SverreOK/hoppen_fc/hoppen_fc/hoppen_fc.kicad_pcb

## KiCad design hoppen_fc/hoppen_fc.kicad_pcb (2026-03-31)

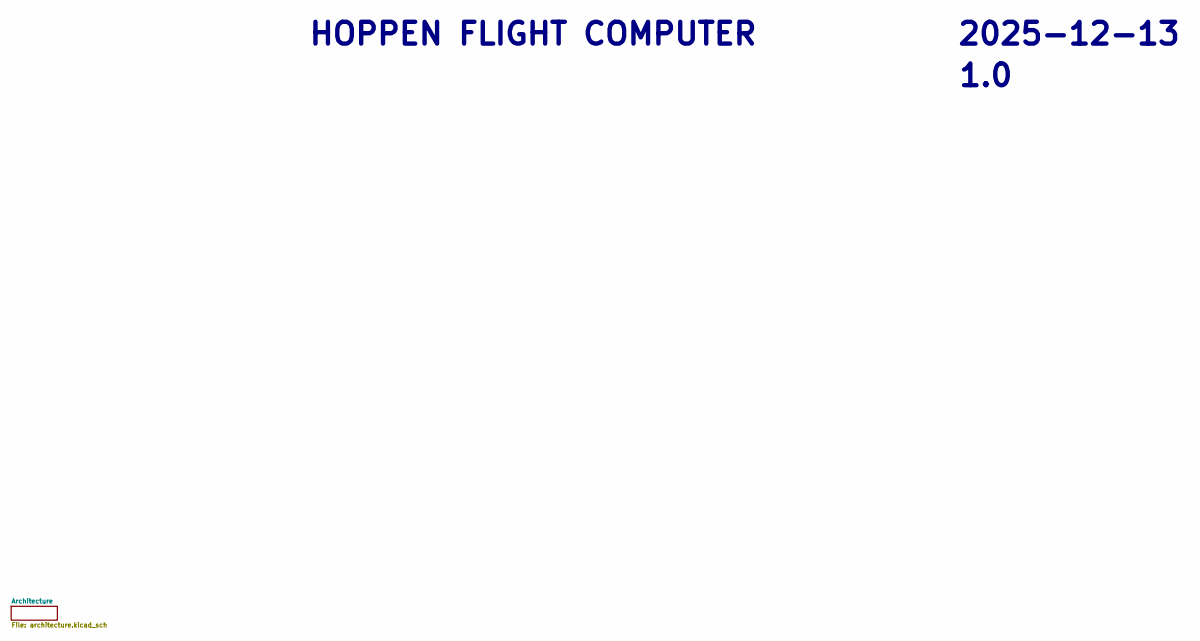
[picture p1: schematic hoppen_fc.kicad_sch, MCU Power]

Notes on the sheet:
${REVISION}
HOPPEN FLIGHT COMPUTER
${ISSUE_DATE}

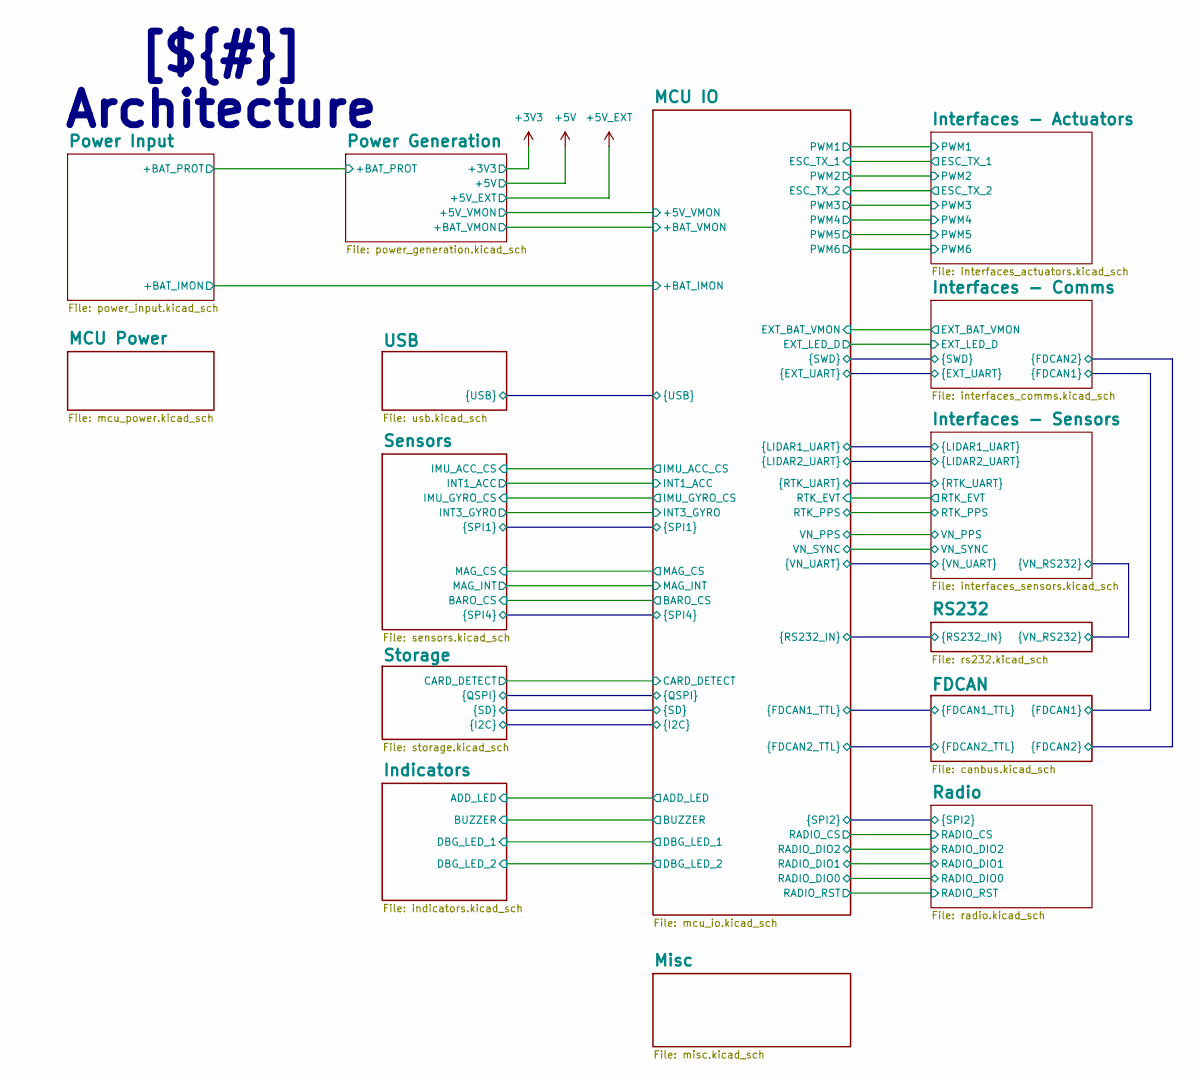
[picture p2: schematic architecture.kicad_sch]

Notes on the sheet:
[${#}] ${TITLE}

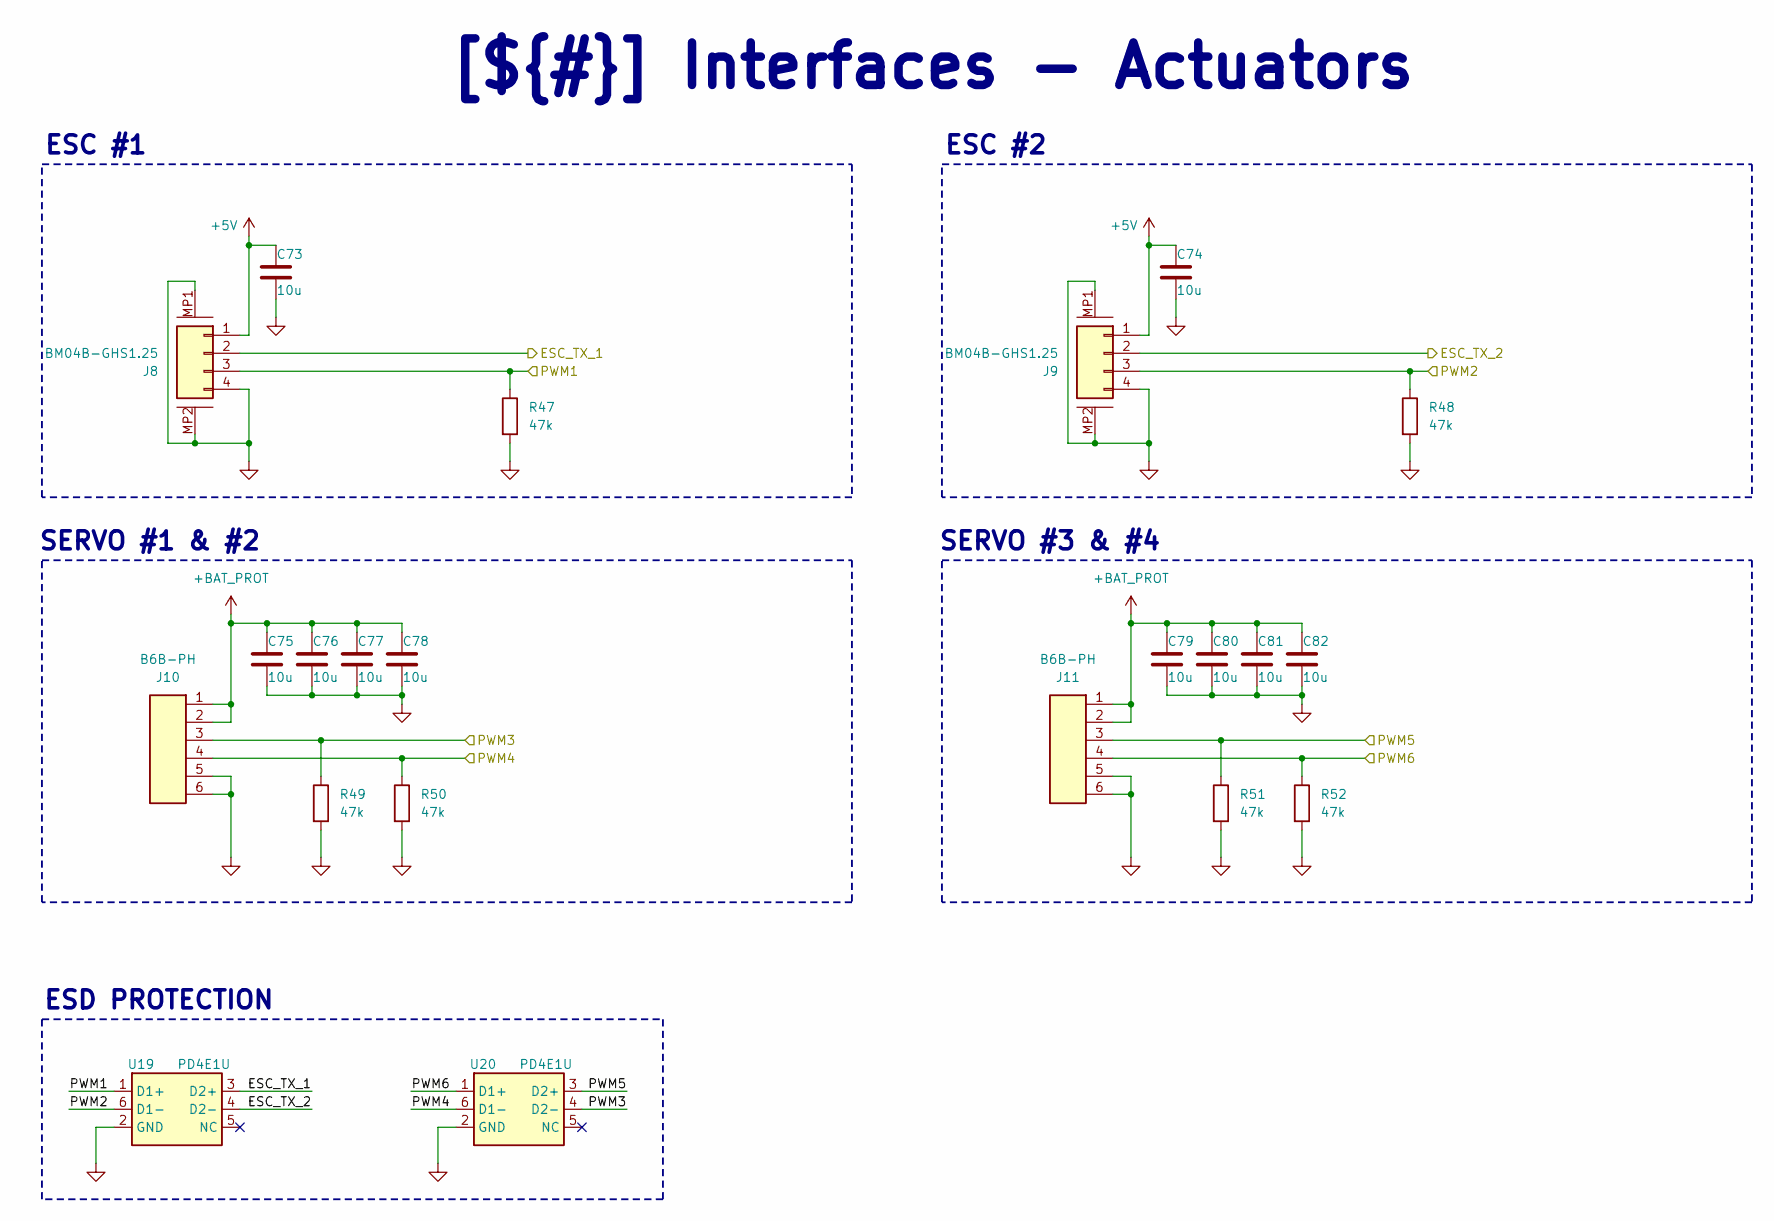
[picture p3: schematic interfaces_actuators.kicad_sch, Interfaces - Actuators]

Parts:
C73, C74, C75, C76, C77, C78, C79, C80, C81, C82: 10u; C_0805_2012Metric; LCSC C440198
J8, J9: BM04B-GHS1.25; LCSC C161692
J10, J11: B6B-PH; JST_PH_B6B-PH-K_1x06_P2.00mm_Vertical
R47, R48, R49, R50, R51, R52: 47k; R_0402_1005Metric; LCSC C25792
U19, U20: PD4E1U; SOT-363_SC-70-6; LCSC C194628

Connections:
+5V: C73.1, C74.1, J8.1, J9.1; also elsewhere on the board
+BAT_PROT: C75.1, C76.1, C77.1, C78.1, C79.1, C80.1, C81.1, C82.1, J10.1, J10.2, J11.1, J11.2; also elsewhere on the board
/Architecture/Interfaces - Actuators/ESC_TX_1: J8.2, U19.3 (D2+); also elsewhere on the board
/Architecture/Interfaces - Actuators/ESC_TX_2: J9.2, U19.4 (D2-); also elsewhere on the board
/Architecture/Interfaces - Actuators/PWM1: J8.3, R47.1, U19.1 (D1+); also elsewhere on the board
/Architecture/Interfaces - Actuators/PWM2: J9.3, R48.1, U19.6 (D1-); also elsewhere on the board
/Architecture/Interfaces - Actuators/PWM3: J10.3, R49.1, U20.4 (D2-); also elsewhere on the board
/Architecture/Interfaces - Actuators/PWM4: J10.4, R50.1, U20.6 (D1-); also elsewhere on the board
/Architecture/Interfaces - Actuators/PWM5: J11.3, R51.1, U20.3 (D2+); also elsewhere on the board
/Architecture/Interfaces - Actuators/PWM6: J11.4, R52.1, U20.1 (D1+); also elsewhere on the board
GND: C73.2, C74.2, C75.2, C76.2, C77.2, C78.2, C79.2, C80.2, C81.2, C82.2, J8.4, J8.MP1, J8.MP2, J9.4, J9.MP1, J9.MP2, J10.5, J10.6, J11.5, J11.6, R47.2, R48.2, R49.2, R50.2, R51.2, R52.2, U19.2 (GND), U20.2 (GND); also elsewhere on the board

Notes on the sheet:
SERVO #1 & #2
ESD PROTECTION
SERVO #3 & #4
ESC #2
ESC #1
[${#}] ${TITLE}

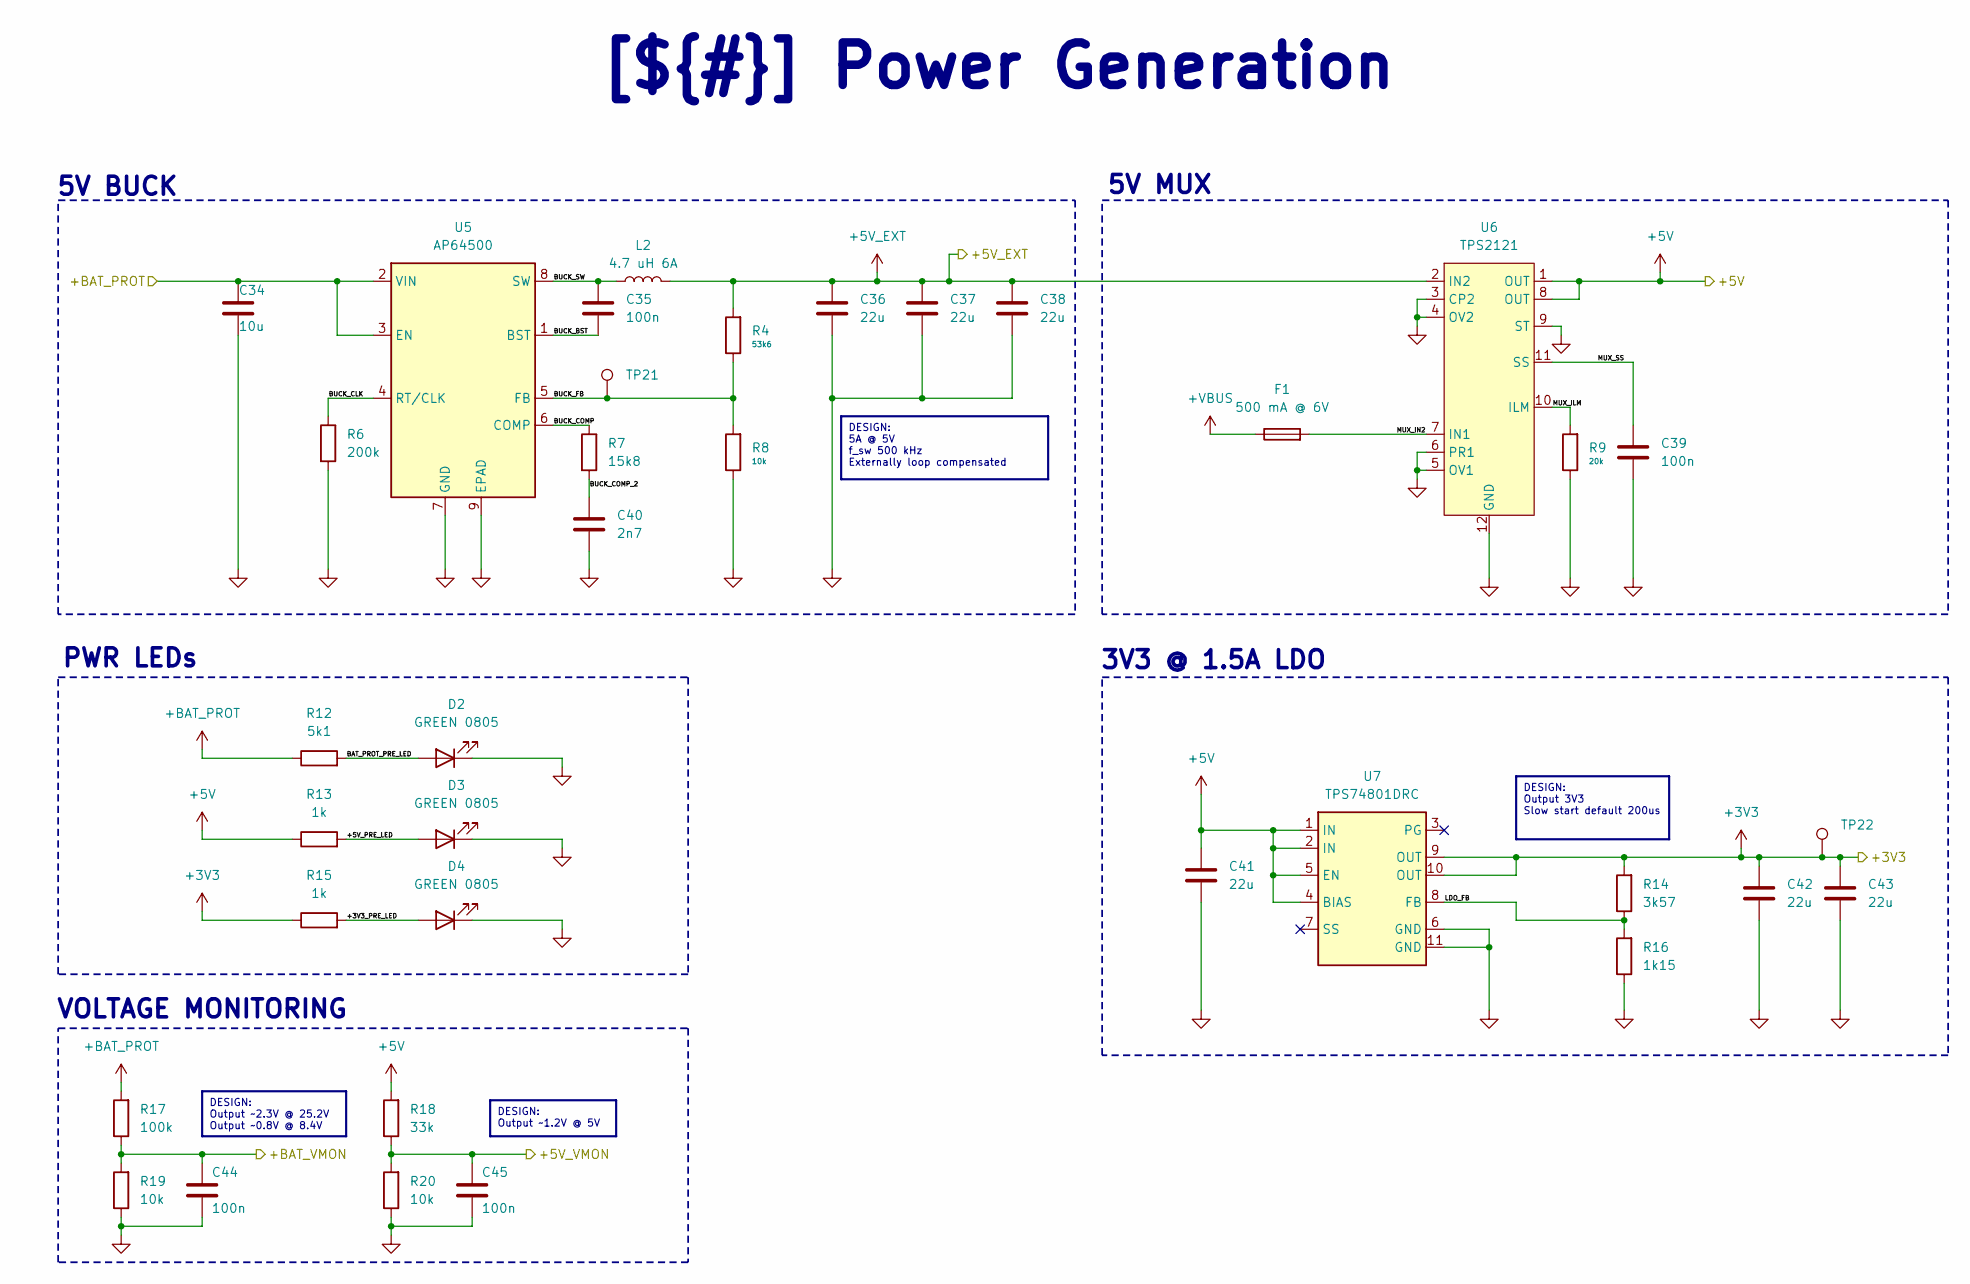
[picture p4: schematic power_generation.kicad_sch, Power Generation]

Parts:
C34: 10u; C_0805_2012Metric; LCSC C440198
C35, C39, C44, C45: 100n; C_0402_1005Metric; LCSC C307331
C36, C37, C38, C41, C42, C43: 22u; C_0805_2012Metric; LCSC C45783
C40: 2n7; C_0402_1005Metric; LCSC C106251
D2, D3, D4: GREEN 0805; LED_0805_2012Metric; LCSC C2297
F1: 500 mA @ 6V; Fuse_0603_1608Metric; LCSC C210357
L2: 4.7 uH 6A; IND-SMD_L7.2-W6.6_GPSR07X0; LCSC C5189754
R4: 53k6; R_0402_1005Metric; LCSC C53398
R6: 200k; R_0402_1005Metric; LCSC C25764
R7: 15k8; R_0402_1005Metric; LCSC C26956
R8, R19, R20: 10k; R_0402_1005Metric; LCSC C25744
R9: 20k; R_0402_1005Metric; LCSC C25765
R12: 5k1; R_0402_1005Metric; LCSC C25905
R13, R15: 1k; R_0402_1005Metric; LCSC C106235
R14: 3k57; R_0402_1005Metric; LCSC C270609
R16: 1k15; R_0402_1005Metric; LCSC C5159680
R17: 100k; R_0402_1005Metric; LCSC C25741
R18: 33k; R_0402_1005Metric; LCSC C25779
TP21, TP22: TestPoint; TestPoint_Pad_1.0x1.0mm
U5: AP64500; SO-8-EP; LCSC C2070920
U6: TPS2121; Texas_VQFN-HR-12_2x2.5mm_P0.5mm; LCSC C2156025
U7: TPS74801DRC; VSON-10; LCSC C105263

Connections:
+3V3: C42.1, C43.1, R14.2, R15.1, TP22.1, U7.9 (OUT), U7.10 (OUT); also elsewhere on the board
+5V: C41.1, R13.1, R18.2, U6.1 (OUT), U6.8 (OUT), U7.1 (IN), U7.2 (IN), U7.4 (BIAS), U7.5 (EN); also elsewhere on the board
+5V_EXT: C36.1, C37.1, C38.1, L2.2, R4.2, U6.2 (IN2); also elsewhere on the board
+BAT_PROT: C34.1, R12.1, R17.2, U5.2 (VIN), U5.3 (EN); also elsewhere on the board
+VBUS: F1.1; also elsewhere on the board
/Architecture/MCU IO/+5V_VMON: C45.2, R18.1, R20.2; also elsewhere on the board
/Architecture/MCU IO/+BAT_VMON: C44.2, R17.1, R19.2; also elsewhere on the board
/Architecture/Power Generation/+3V3_PRE_LED: D4.2 (A), R15.2
/Architecture/Power Generation/+5V_PRE_LED: D3.2 (A), R13.2
/Architecture/Power Generation/BAT_PROT_PRE_LED: D2.2 (A), R12.2
/Architecture/Power Generation/BUCK_BST: C35.2, U5.1 (BST)
/Architecture/Power Generation/BUCK_CLK: R6.1, U5.4 (RT/CLK)
/Architecture/Power Generation/BUCK_COMP: R7.1, U5.6 (COMP)
/Architecture/Power Generation/BUCK_COMP_2: C40.1, R7.2
/Architecture/Power Generation/BUCK_FB: R4.1, R8.2, TP21.1, U5.5 (FB)
/Architecture/Power Generation/BUCK_SW: C35.1, L2.1, U5.8 (SW)
/Architecture/Power Generation/LDO_FB: R14.1, R16.2, U7.8 (FB)
/Architecture/Power Generation/MUX_ILM: R9.2, U6.10 (ILM)
/Architecture/Power Generation/MUX_IN2: F1.2, U6.7 (IN1)
/Architecture/Power Generation/MUX_SS: C39.1, U6.11 (SS)
GND: C34.2, C36.2, C37.2, C38.2, C39.2, C40.2, C41.2, C42.2, C43.2, C44.1, C45.1, D2.1 (K), D3.1 (K), D4.1 (K), R6.2, R8.1, R9.1, R16.1, R19.1, R20.1, U5.7 (GND), U5.9 (EPAD), U6.3 (CP2), U6.4 (OV2), U6.5 (OV1), U6.6 (PR1), U6.9 (ST), U6.12 (GND), U7.6 (GND), U7.11 (GND); also elsewhere on the board

Notes on the sheet:
5V MUX
PWR LEDs
5V BUCK
VOLTAGE MONITORING
3V3 @ 1.5A LDO
[${#}] ${TITLE}
DESIGN: Output 3V3 Slow start default 200us
DESIGN: 5A @ 5V f_sw 500 kHz Externally loop compensated
DESIGN: Output ~1.2V @ 5V
DESIGN: Output ~2.3V @ 25.2V Output ~0.8V @ 8.4V

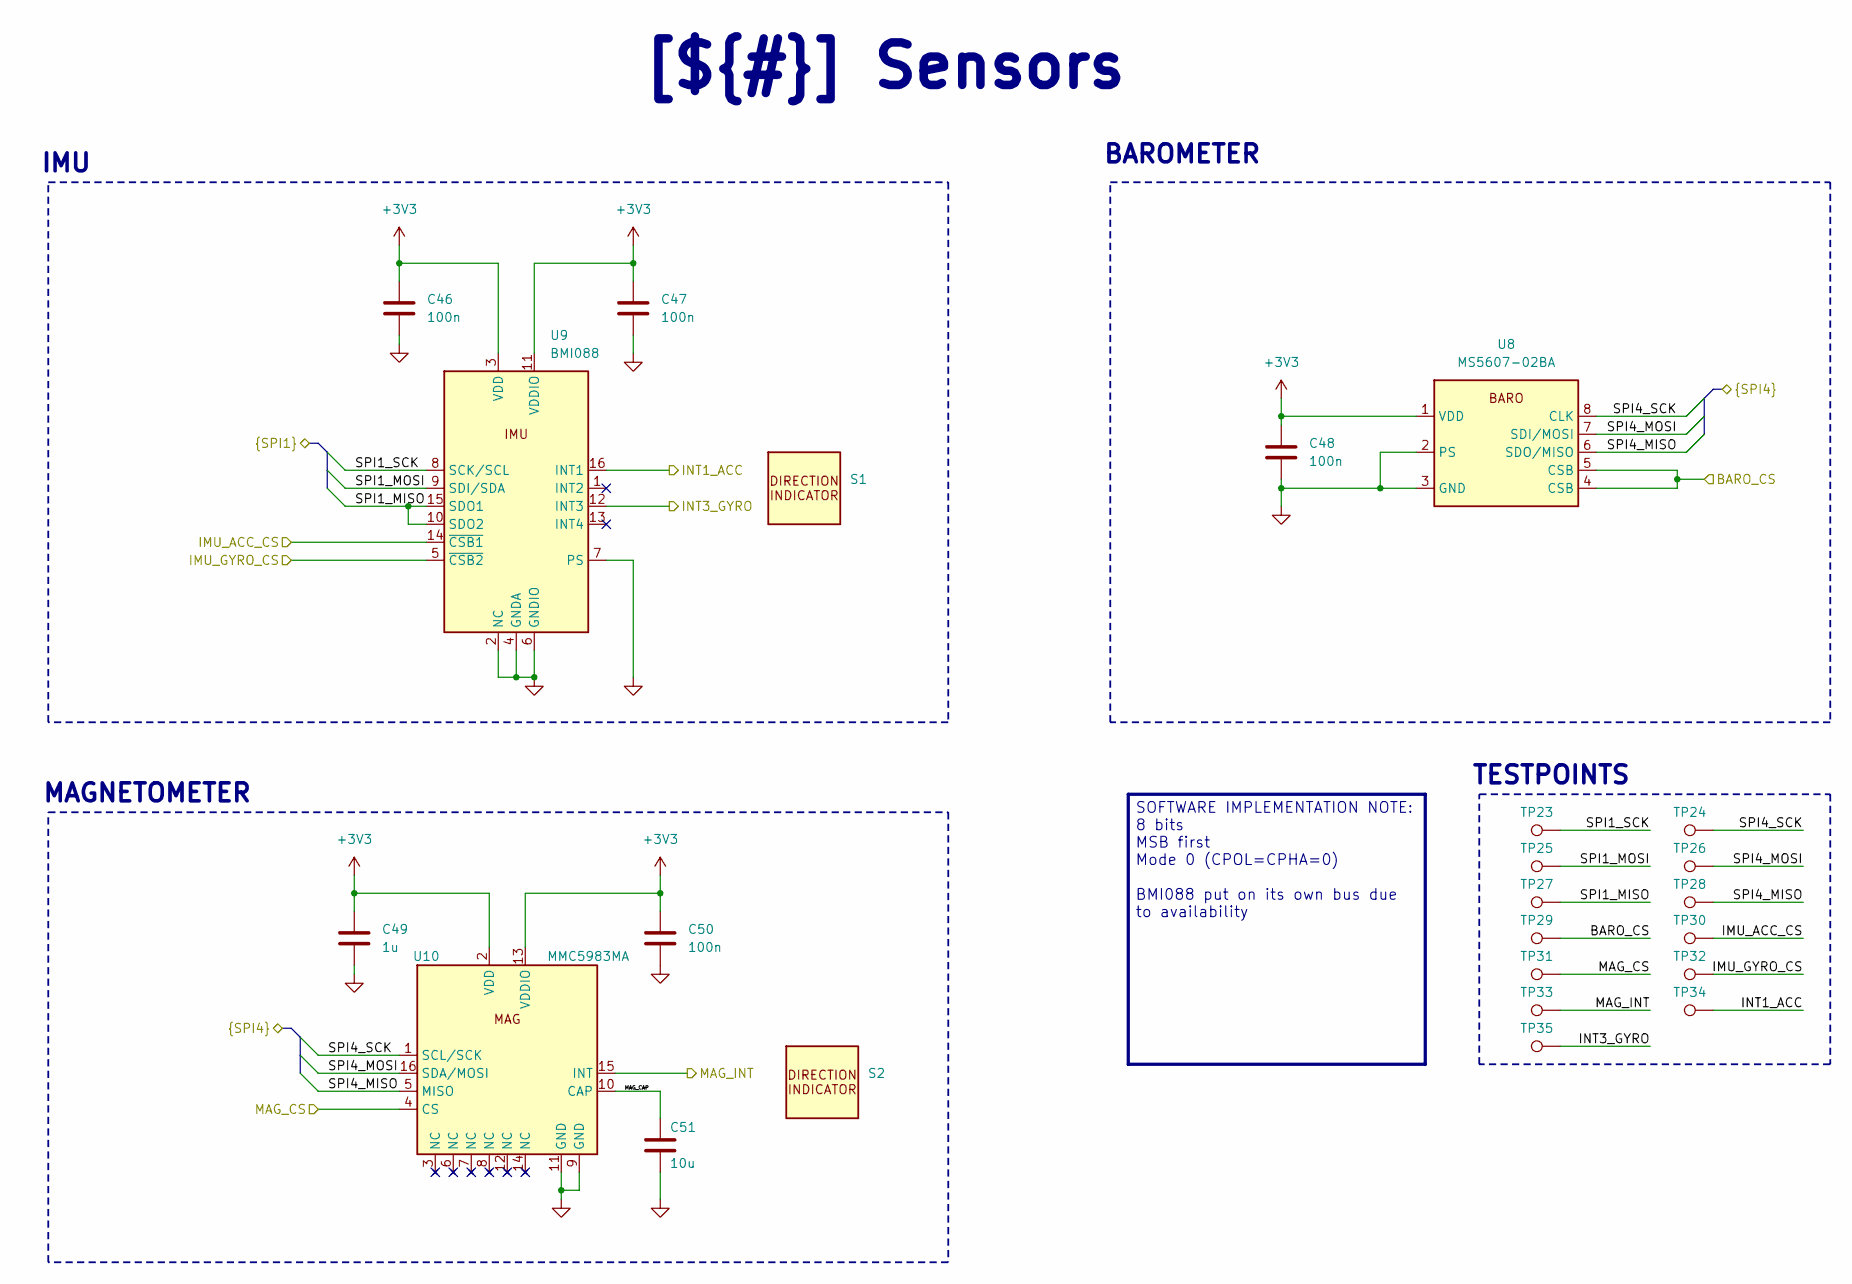
[picture p5: schematic sensors.kicad_sch]

Parts:
C46, C47, C48, C50: 100n; C_0402_1005Metric; LCSC C307331
C49: 1u; C_0402_1005Metric; LCSC C52923
C51: 10u; C_0805_2012Metric; LCSC C440198
S1: right_hand_rule
S2: right_hand_rule_2
TP23, TP24, TP25, TP26, TP27, TP28, TP29, TP30, TP31, TP32, TP33, TP34, TP35: TestPoint; TestPoint_Pad_1.0x1.0mm
U8: MS5607-02BA; LGA-8_3x5mm_P1.25mm; LCSC C97627
U9: BMI088; Bosch_LGA-16_4.5x3mm_P0.5mm_LayoutBorder7x1y_ClockwisePinNu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; LCSC C194919
U10: MMC5983MA; LGA-16_3x3mm_P0.5mm; LCSC C404329

Connections:
+3V3: C46.1, C47.1, C48.1, C49.1, C50.1, U8.1 (VDD), U9.3 (VDD), U9.11 (VDDIO), U10.2 (VDD), U10.13 (VDDIO); also elsewhere on the board
/Architecture/MCU IO/BARO_CS: TP29.1, U8.4 (CSB), U8.5 (CSB); also elsewhere on the board
/Architecture/MCU IO/IMU_ACC_CS: TP30.1, U9.14 (~CSB1); also elsewhere on the board
/Architecture/MCU IO/IMU_GYRO_CS: TP32.1, U9.5 (~CSB2); also elsewhere on the board
/Architecture/MCU IO/INT1_ACC: TP34.1, U9.16 (INT1); also elsewhere on the board
/Architecture/MCU IO/INT3_GYRO: TP35.1, U9.12 (INT3); also elsewhere on the board
/Architecture/MCU IO/MAG_CS: TP31.1, U10.4 (CS); also elsewhere on the board
/Architecture/MCU IO/MAG_INT: TP33.1, U10.15 (INT); also elsewhere on the board
/Architecture/MCU IO/SPI1_MISO: TP27.1, U9.10 (SDO2), U9.15 (SDO1); also elsewhere on the board
/Architecture/MCU IO/SPI1_MOSI: TP25.1, U9.9 (SDI/SDA); also elsewhere on the board
/Architecture/MCU IO/SPI1_SCK: TP23.1, U9.8 (SCK/SCL); also elsewhere on the board
/Architecture/MCU IO/SPI4_MISO: TP28.1, U8.6 (SDO/MISO), U10.5 (MISO); also elsewhere on the board
/Architecture/MCU IO/SPI4_MOSI: TP26.1, U8.7 (SDI/MOSI), U10.16 (SDA/MOSI); also elsewhere on the board
/Architecture/MCU IO/SPI4_SCK: TP24.1, U8.8 (CLK), U10.1 (SCL/SCK); also elsewhere on the board
/Architecture/Sensors/MAG_CAP: C51.2, U10.10 (CAP)
GND: C46.2, C47.2, C48.2, C49.2, C50.2, C51.1, U8.2 (PS), U8.3 (GND), U9.2 (NC), U9.4 (GNDA), U9.6 (GNDIO), U9.7 (PS), U10.9 (GND), U10.11 (GND); also elsewhere on the board

Notes on the sheet:
BAROMETER
MAGNETOMETER
TESTPOINTS
IMU
[${#}] ${TITLE}
SOFTWARE IMPLEMENTATION NOTE: 8 bits MSB first Mode 0 (CPOL=CPHA=0) BMI088 put on its own bus due to availability

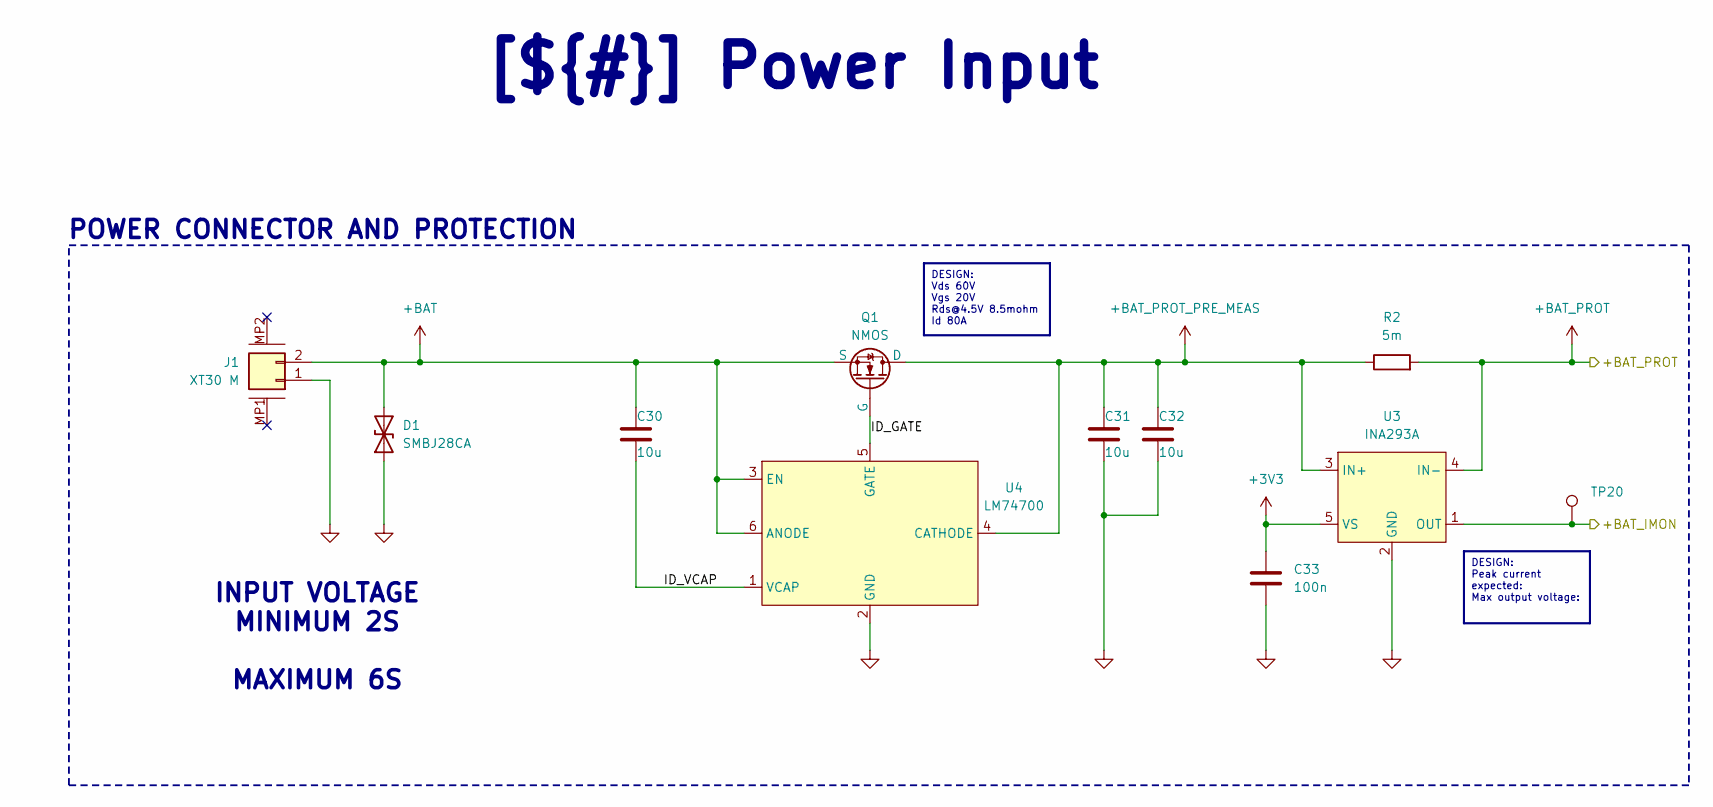
[picture p6: schematic power_input.kicad_sch, Power Input]

Parts:
C30, C31, C32: 10u; C_0805_2012Metric; LCSC C440198
C33: 100n; C_0402_1005Metric; LCSC C307331
D1: SMBJ28CA; D_SMB; LCSC C19077583
J1: XT30 M; XT30PW-M
Q1: NMOS; Diodes_PowerDI3333-8; LCSC C2802568
R2: 5m; R_2512_6332Metric; LCSC C185817
TP20: TestPoint; TestPoint_Pad_1.0x1.0mm
U3: INA293A; SOT-23-5; LCSC C1855790
U4: LM74700; SOT-23-6; LCSC C2941042

Connections:
+3V3: C33.1, U3.5 (VS); also elsewhere on the board
+BAT: C30.1, D1.2 (A2), J1.2, Q1.3 (S), U4.3 (EN), U4.6 (ANODE)
+BAT_PROT: R2.2, U3.4 (IN-); also elsewhere on the board
+BAT_PROT_PRE_MEAS: C31.1, C32.1, Q1.1 (D), R2.1, U3.3 (IN+), U4.4 (CATHODE)
/Architecture/MCU IO/+BAT_IMON: TP20.1, U3.1 (OUT); also elsewhere on the board
/Architecture/Power Input/ID_GATE: Q1.2 (G), U4.5 (GATE)
/Architecture/Power Input/ID_VCAP: C30.2, U4.1 (VCAP)
GND: C31.2, C32.2, C33.2, D1.1 (A1), J1.1, U3.2 (GND), U4.2 (GND); also elsewhere on the board

Notes on the sheet:
POWER CONNECTOR AND PROTECTION
INPUT VOLTAGE MINIMUM 2S MAXIMUM 6S
DESIGN: Peak current expected: Max output voltage:
[${#}] ${TITLE}
DESIGN: Vds 60V Vgs 20V Rds@4.5V 8.5mohm Id 80A

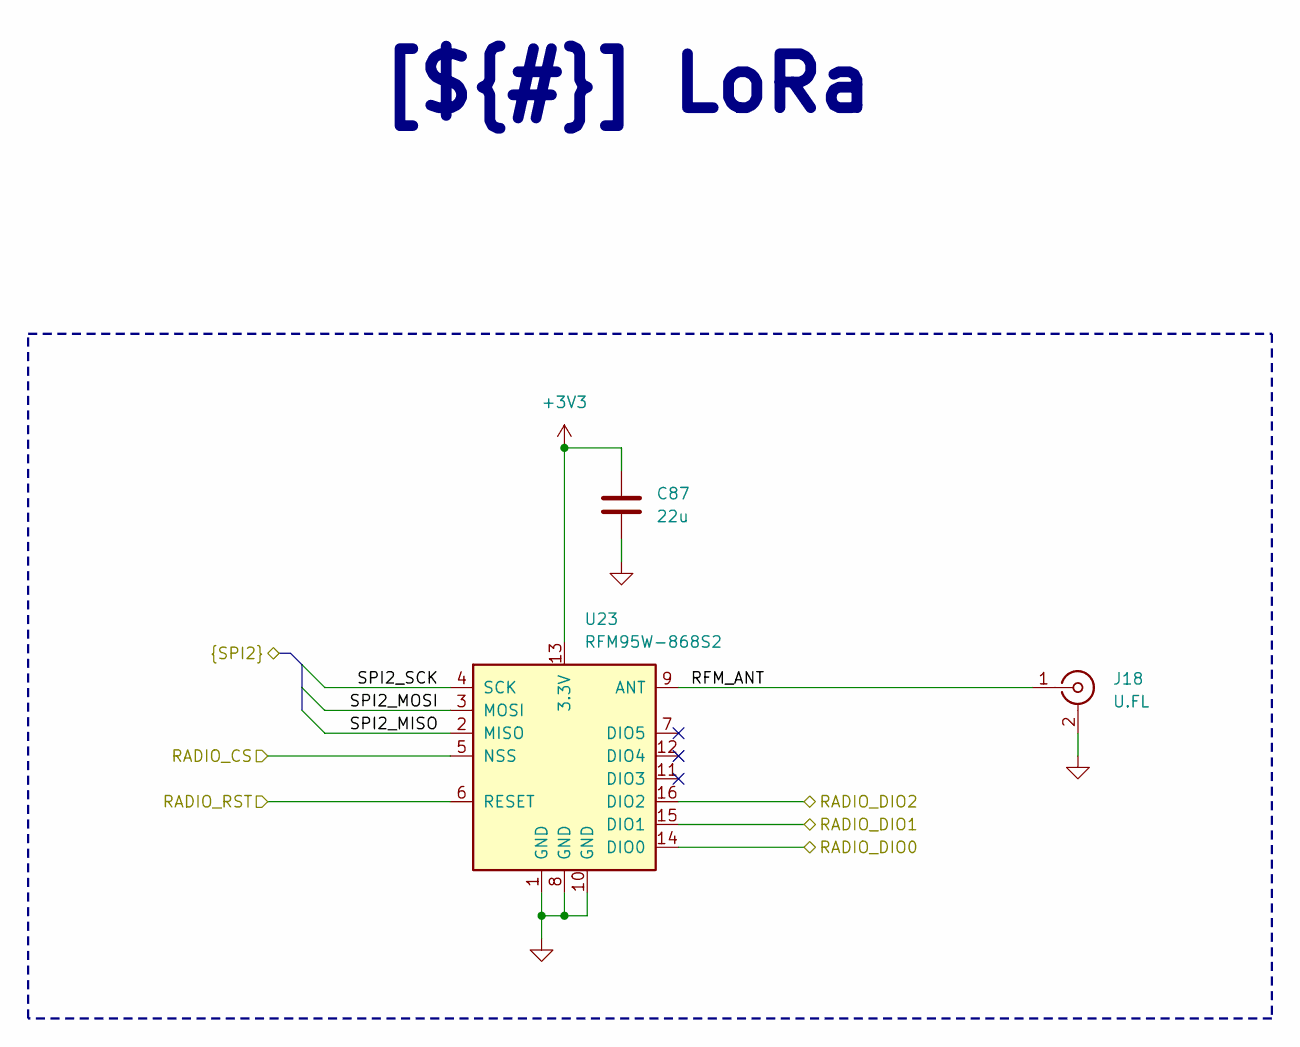
[picture p7: schematic radio.kicad_sch, LoRa]

Parts:
C87: 22u; C_0805_2012Metric; LCSC C45783
J18: U.FL; U.FL_Hirose_U.FL-R-SMT-1_Vertical; LCSC C88374
U23: RFM95W-868S2; HOPERF_RFM9XW_SMD

Connections:
+3V3: C87.1, U23.13 (3.3V); also elsewhere on the board
/Architecture/MCU IO/RADIO_CS: U23.5 (NSS); also elsewhere on the board
/Architecture/MCU IO/RADIO_DIO0: U23.14 (DIO0); also elsewhere on the board
/Architecture/MCU IO/RADIO_DIO1: U23.15 (DIO1); also elsewhere on the board
/Architecture/MCU IO/RADIO_DIO2: U23.16 (DIO2); also elsewhere on the board
/Architecture/MCU IO/RADIO_RST: U23.6 (RESET); also elsewhere on the board
/Architecture/MCU IO/SPI2_MISO: U23.2 (MISO); also elsewhere on the board
/Architecture/MCU IO/SPI2_MOSI: U23.3 (MOSI); also elsewhere on the board
/Architecture/MCU IO/SPI2_SCK: U23.4 (SCK); also elsewhere on the board
/Architecture/Radio/RFM_ANT: J18.1 (In), U23.9 (ANT)
GND: C87.2, J18.2 (Ext), U23.1 (GND), U23.8 (GND), U23.10 (GND); also elsewhere on the board

Notes on the sheet:
[${#}] ${TITLE}

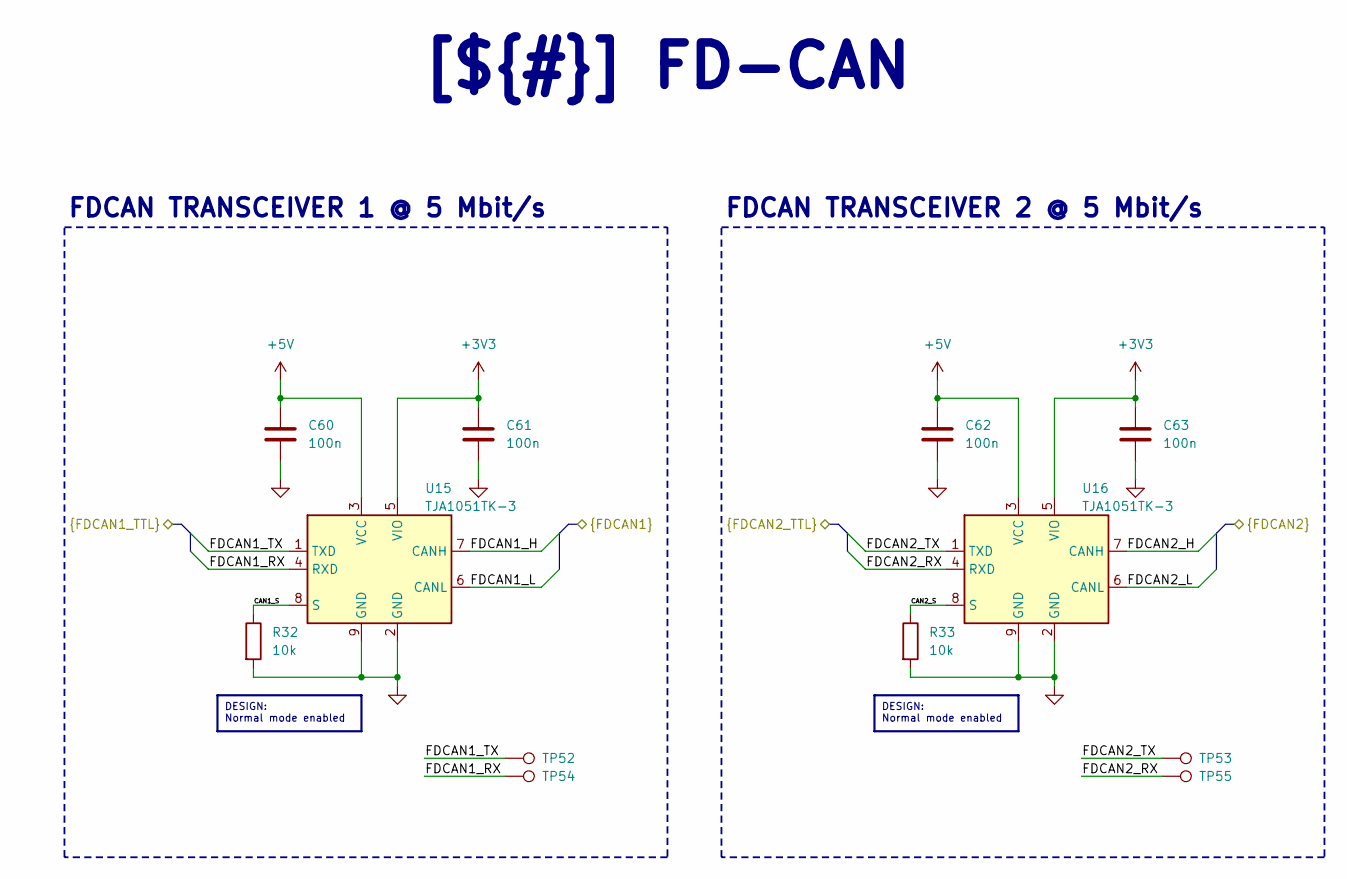
[picture p8: schematic canbus.kicad_sch, FD-CAN]

Parts:
C60, C61, C62, C63: 100n; C_0402_1005Metric; LCSC C307331
R32, R33: 10k; R_0402_1005Metric; LCSC C25744
TP52, TP53, TP54, TP55: TestPoint; TestPoint_Pad_1.0x1.0mm
U15, U16: TJA1051TK-3; HVSON-8-1EP_3x3mm_P0.65mm_EP1.6x2.4mm; LCSC C2875699

Connections:
+3V3: C61.1, C63.1, U15.5 (VIO), U16.5 (VIO); also elsewhere on the board
+5V: C60.1, C62.1, U15.3 (VCC), U16.3 (VCC); also elsewhere on the board
/Architecture/FDCAN/CAN1_S: R32.1, U15.8 (S)
/Architecture/FDCAN/CAN2_S: R33.1, U16.8 (S)
/Architecture/FDCAN/FDCAN1_H: U15.7 (CANH); also elsewhere on the board
/Architecture/FDCAN/FDCAN1_L: U15.6 (CANL); also elsewhere on the board
/Architecture/FDCAN/FDCAN1_RX: TP54.1, U15.4 (RXD); also elsewhere on the board
/Architecture/FDCAN/FDCAN1_TX: TP52.1, U15.1 (TXD); also elsewhere on the board
/Architecture/FDCAN/FDCAN2_H: U16.7 (CANH); also elsewhere on the board
/Architecture/FDCAN/FDCAN2_L: U16.6 (CANL); also elsewhere on the board
/Architecture/FDCAN/FDCAN2_RX: TP55.1, U16.4 (RXD); also elsewhere on the board
/Architecture/FDCAN/FDCAN2_TX: TP53.1, U16.1 (TXD); also elsewhere on the board
GND: C60.2, C61.2, C62.2, C63.2, R32.2, R33.2, U15.2 (GND), U15.9 (GND), U16.2 (GND), U16.9 (GND); also elsewhere on the board

Notes on the sheet:
FDCAN TRANSCEIVER 1 @ 5 Mbit/s
FDCAN TRANSCEIVER 2 @ 5 Mbit/s
[${#}] ${TITLE}
DESIGN: Normal mode enabled
