SverreOK/hoppen_fc/hoppen_fc/hoppen_fc.kicad_pcb

## KiCad design hoppen_fc/hoppen_fc.kicad_pcb (continued)

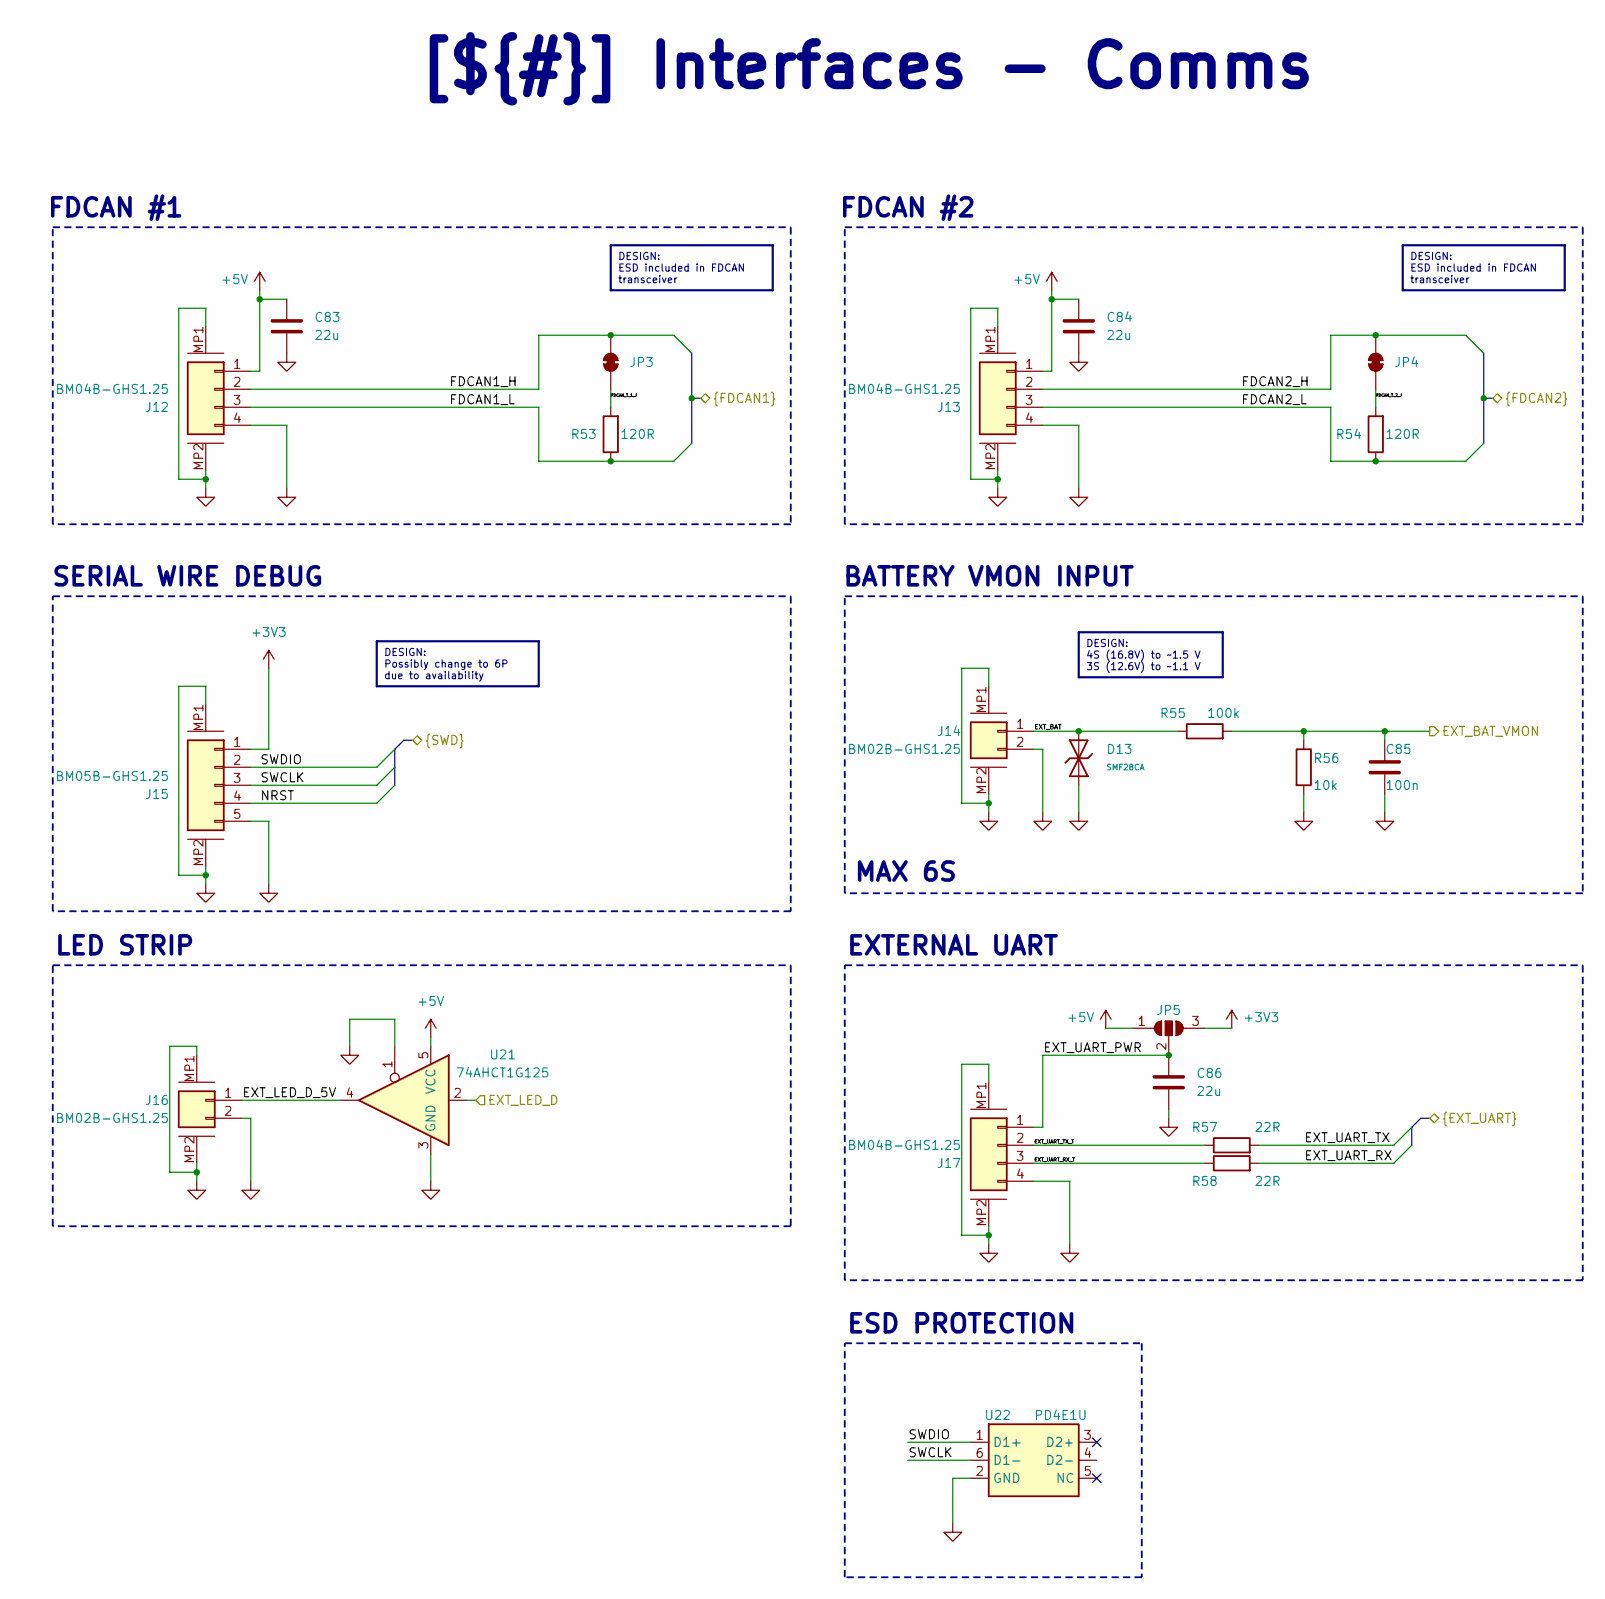
[picture p9: schematic interfaces_comms.kicad_sch, Interfaces - Comms]

Parts:
C83, C84, C86: 22u; C_0805_2012Metric; LCSC C45783
C85: 100n; C_0402_1005Metric; LCSC C307331
D13: SMF28CA; D_SOD-123FL; Part SMF28CA; LCSC C19077517
J12, J13, J17: BM04B-GHS1.25; LCSC C161692
J14, J16: BM02B-GHS1.25; LCSC C225118
J15: BM05B-GHS1.25; LCSC C225121
JP3, JP4: J; SolderJumper-2_P1.3mm_Bridged_RoundedPad1.0x1.5mm
JP5: SolderJumper_3_Open; SolderJumper-3_P1.3mm_Open_Pad1.0x1.5mm
R53, R54: 120R; R_0402_1005Metric; LCSC C25079
R55: 100k; R_0402_1005Metric; LCSC C25741
R56: 10k; R_0402_1005Metric; LCSC C25744
R57, R58: 22R; R_0402_1005Metric; LCSC C2929994
U21: 74AHCT1G125; SOT-23-5; LCSC C20617903
U22: PD4E1U; SOT-363_SC-70-6; LCSC C194628

Connections:
+3V3: J15.1, JP5.3 (B); also elsewhere on the board
+5V: C83.1, C84.1, J12.1, J13.1, JP5.1 (A), U21.5 (VCC); also elsewhere on the board
/Architecture/FDCAN/FDCAN1_H: J12.2, JP3.2 (B); also elsewhere on the board
/Architecture/FDCAN/FDCAN1_L: J12.3, R53.1; also elsewhere on the board
/Architecture/FDCAN/FDCAN2_H: J13.2, JP4.2 (B); also elsewhere on the board
/Architecture/FDCAN/FDCAN2_L: J13.3, R54.1; also elsewhere on the board
/Architecture/Interfaces - Comms/EXT_BAT: D13.2, J14.1, R55.1
/Architecture/Interfaces - Comms/EXT_LED_D_5V: J16.1, U21.4
/Architecture/Interfaces - Comms/EXT_UART_PWR: C86.1, J17.1, JP5.2 (C)
/Architecture/Interfaces - Comms/EXT_UART_RX: R58.2; also elsewhere on the board
/Architecture/Interfaces - Comms/EXT_UART_RX_T: J17.3, R58.1
/Architecture/Interfaces - Comms/EXT_UART_TX: R57.2; also elsewhere on the board
/Architecture/Interfaces - Comms/EXT_UART_TX_T: J17.2, R57.1
/Architecture/Interfaces - Comms/FDCAN_T_1_J: JP3.1 (A), R53.2
/Architecture/Interfaces - Comms/FDCAN_T_2_J: JP4.1 (A), R54.2
/Architecture/Interfaces - Comms/NRST: J15.4; also elsewhere on the board
/Architecture/Interfaces - Comms/SWCLK: J15.3, U22.6 (D1-); also elsewhere on the board
/Architecture/Interfaces - Comms/SWDIO: J15.2, U22.1 (D1+); also elsewhere on the board
/Architecture/MCU IO/EXT_BAT_VMON: C85.1, R55.2, R56.1; also elsewhere on the board
/Architecture/MCU IO/EXT_LED_D: U21.2; also elsewhere on the board
GND: C83.2, C84.2, C85.2, C86.2, D13.1, J12.4, J12.MP1, J12.MP2, J13.4, J13.MP1, J13.MP2, J14.2, J14.MP1, J14.MP2, J15.5, J15.MP1, J15.MP2, J16.2, J16.MP1, J16.MP2, J17.4, J17.MP1, J17.MP2, R56.2, U21.1, U21.3 (GND), U22.2 (GND); also elsewhere on the board

Notes on the sheet:
FDCAN #1
SERIAL WIRE DEBUG
BATTERY VMON INPUT
MAX 6S
ESD PROTECTION
EXTERNAL UART
FDCAN #2
LED STRIP
[${#}] ${TITLE}
DESIGN: Possibly change to 6P due to availability
DESIGN: ESD included in FDCAN transceiver
DESIGN: 4S (16.8V) to ~1.5 V 3S (12.6V) to ~1.1 V

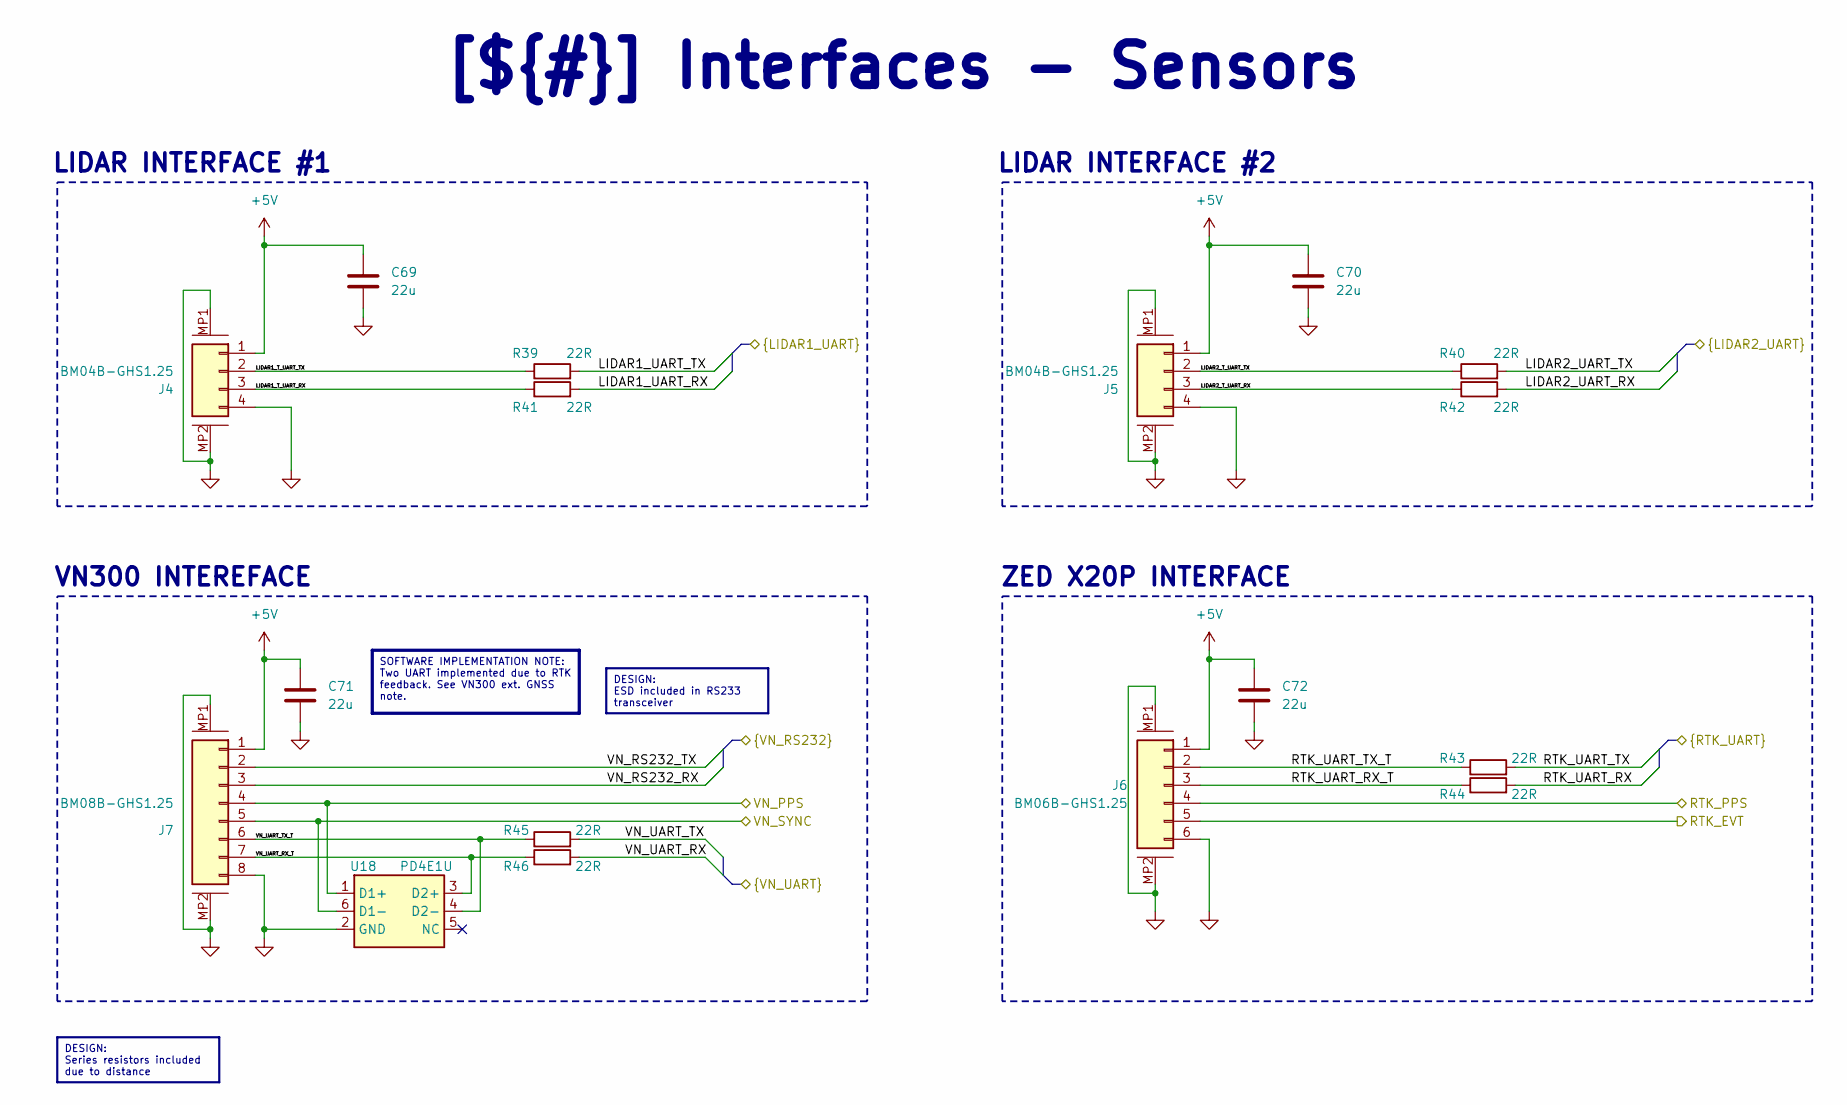
[picture p10: schematic interfaces_sensors.kicad_sch, Interfaces - Sensors]

Parts:
C69, C70, C71, C72: 22u; C_0805_2012Metric; LCSC C45783
J4, J5: BM04B-GHS1.25; LCSC C161692
J6: BM06B-GHS1.25; BM06B-GHS-1.25; LCSC C225122
J7: BM08B-GHS1.25; LCSC C133062
R39, R40, R41, R42, R43, R44, R45, R46: 22R; R_0402_1005Metric; LCSC C2929994
U18: PD4E1U; SOT-363_SC-70-6; LCSC C194628

Connections:
+5V: C69.1, C70.1, C71.1, C72.1, J4.1, J5.1, J6.1, J7.1; also elsewhere on the board
/Architecture/Interfaces - Sensors/LIDAR1_T_UART_RX: J4.3, R41.1
/Architecture/Interfaces - Sensors/LIDAR1_T_UART_TX: J4.2, R39.1
/Architecture/Interfaces - Sensors/LIDAR1_UART_RX: R41.2; also elsewhere on the board
/Architecture/Interfaces - Sensors/LIDAR1_UART_TX: R39.2; also elsewhere on the board
/Architecture/Interfaces - Sensors/LIDAR2_T_UART_RX: J5.3, R42.1
/Architecture/Interfaces - Sensors/LIDAR2_T_UART_TX: J5.2, R40.1
/Architecture/Interfaces - Sensors/LIDAR2_UART_RX: R42.2; also elsewhere on the board
/Architecture/Interfaces - Sensors/LIDAR2_UART_TX: R40.2; also elsewhere on the board
/Architecture/Interfaces - Sensors/RTK_UART_RX: R44.2; also elsewhere on the board
/Architecture/Interfaces - Sensors/RTK_UART_RX_T: J6.3, R44.1
/Architecture/Interfaces - Sensors/RTK_UART_TX: R43.2; also elsewhere on the board
/Architecture/Interfaces - Sensors/RTK_UART_TX_T: J6.2, R43.1
/Architecture/Interfaces - Sensors/VN_RS232_RX: J7.3; also elsewhere on the board
/Architecture/Interfaces - Sensors/VN_RS232_TX: J7.2; also elsewhere on the board
/Architecture/Interfaces - Sensors/VN_UART_RX: R46.2; also elsewhere on the board
/Architecture/Interfaces - Sensors/VN_UART_RX_T: J7.7, R46.1, U18.3 (D2+)
/Architecture/Interfaces - Sensors/VN_UART_TX: R45.2; also elsewhere on the board
/Architecture/Interfaces - Sensors/VN_UART_TX_T: J7.6, R45.1, U18.4 (D2-)
/Architecture/MCU IO/RTK_EVT: J6.5; also elsewhere on the board
/Architecture/MCU IO/RTK_PPS: J6.4; also elsewhere on the board
/Architecture/MCU IO/VN_PPS: J7.4, U18.1 (D1+); also elsewhere on the board
/Architecture/MCU IO/VN_SYNC: J7.5, U18.6 (D1-); also elsewhere on the board
GND: C69.2, C70.2, C71.2, C72.2, J4.4, J4.MP1, J4.MP2, J5.4, J5.MP1, J5.MP2, J6.6, J6.MP1, J6.MP2, J7.8, J7.MP1, J7.MP2, U18.2 (GND); also elsewhere on the board

Notes on the sheet:
VN300 INTEREFACE
ZED X20P INTERFACE
LIDAR INTERFACE #2
LIDAR INTERFACE #1
DESIGN: Series resistors included due to distance
DESIGN: ESD included in RS233 transceiver
SOFTWARE IMPLEMENTATION NOTE: Two UART implemented due to RTK feedback. See VN300 ext. GNSS note.
[${#}] ${TITLE}

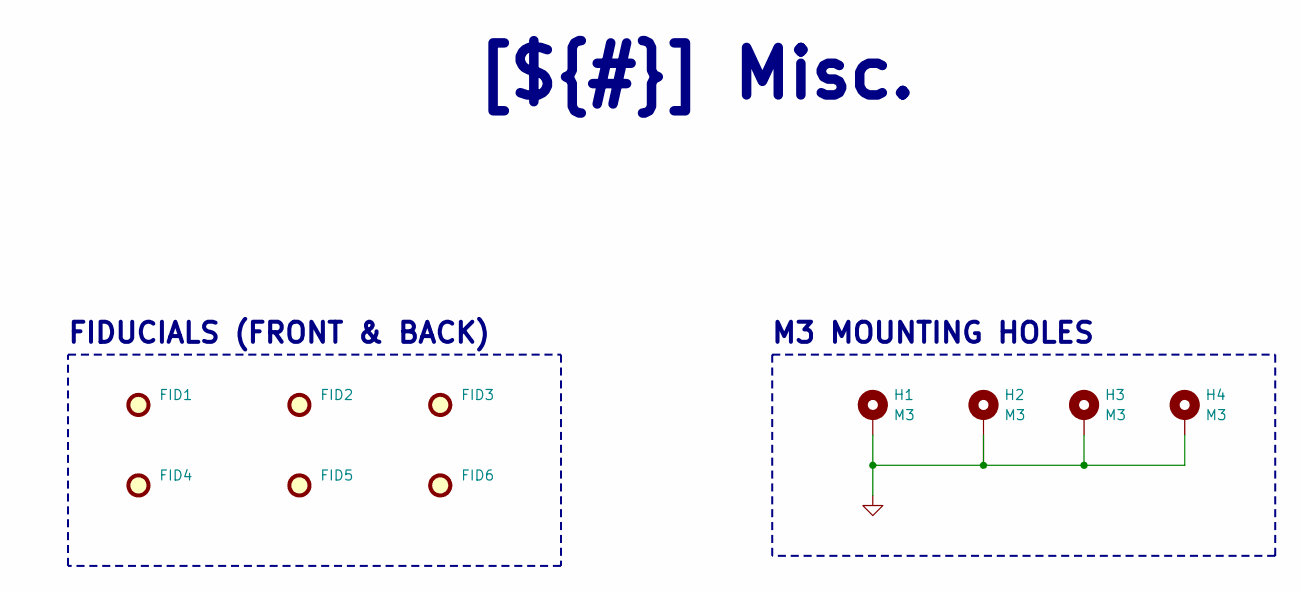
[picture p11: schematic misc.kicad_sch]

Parts:
FID1, FID2, FID3, FID4, FID5, FID6: Fiducial; Fiducial_1mm_Mask2mm
H1, H2, H3, H4: M3; MountingHole_3.2mm_M3_Pad_Via

Connections:
GND: H1.MP, H2.MP, H3.MP, H4.MP; also elsewhere on the board

Notes on the sheet:
FIDUCIALS (FRONT & BACK)
M3 MOUNTING HOLES
[${#}] ${TITLE}

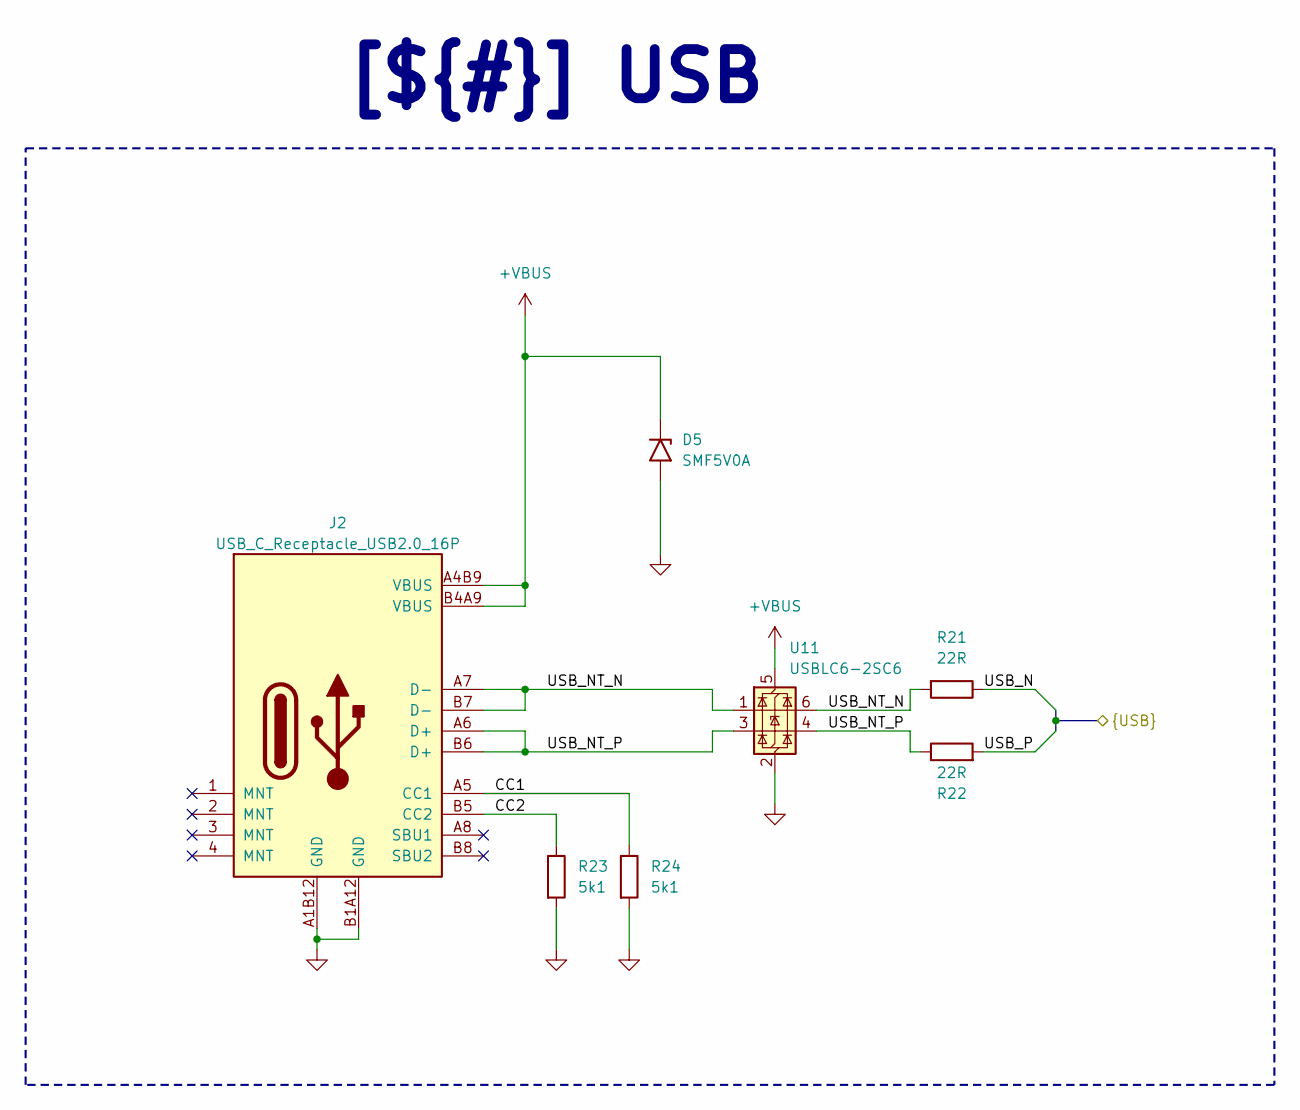
[picture p12: schematic usb.kicad_sch]

Parts:
D5: SMF5V0A; D_SMF; LCSC C1972946
J2: USB_C_Receptacle_USB2.0_16P; USB-C_SMD-TYPE-C-31-M-12_1; LCSC C165948
R21, R22: 22R; R_0402_1005Metric; LCSC C2929994
R23, R24: 5k1; R_0402_1005Metric; LCSC C25905
U11: USBLC6-2SC6; SOT-23-6; LCSC C7519

Connections:
+VBUS: D5.1 (A1), J2.A4B9 (VBUS), J2.B4A9 (VBUS), U11.5 (VBUS); also elsewhere on the board
/Architecture/MCU IO/USB_N: R21.1; also elsewhere on the board
/Architecture/MCU IO/USB_P: R22.2; also elsewhere on the board
/Architecture/USB/CC1: J2.A5 (CC1), R24.1
/Architecture/USB/CC2: J2.B5 (CC2), R23.1
/Architecture/USB/USB_NT_N: J2.A7 (D-), J2.B7 (D-), R21.2, U11.1 (I/O1), U11.6 (I/O1)
/Architecture/USB/USB_NT_P: J2.A6 (D+), J2.B6 (D+), R22.1, U11.3 (I/O2), U11.4 (I/O2)
GND: D5.2 (A2), J2.A1B12 (GND), J2.B1A12 (GND), R23.2, R24.2, U11.2 (GND); also elsewhere on the board

Notes on the sheet:
[${#}] ${TITLE}

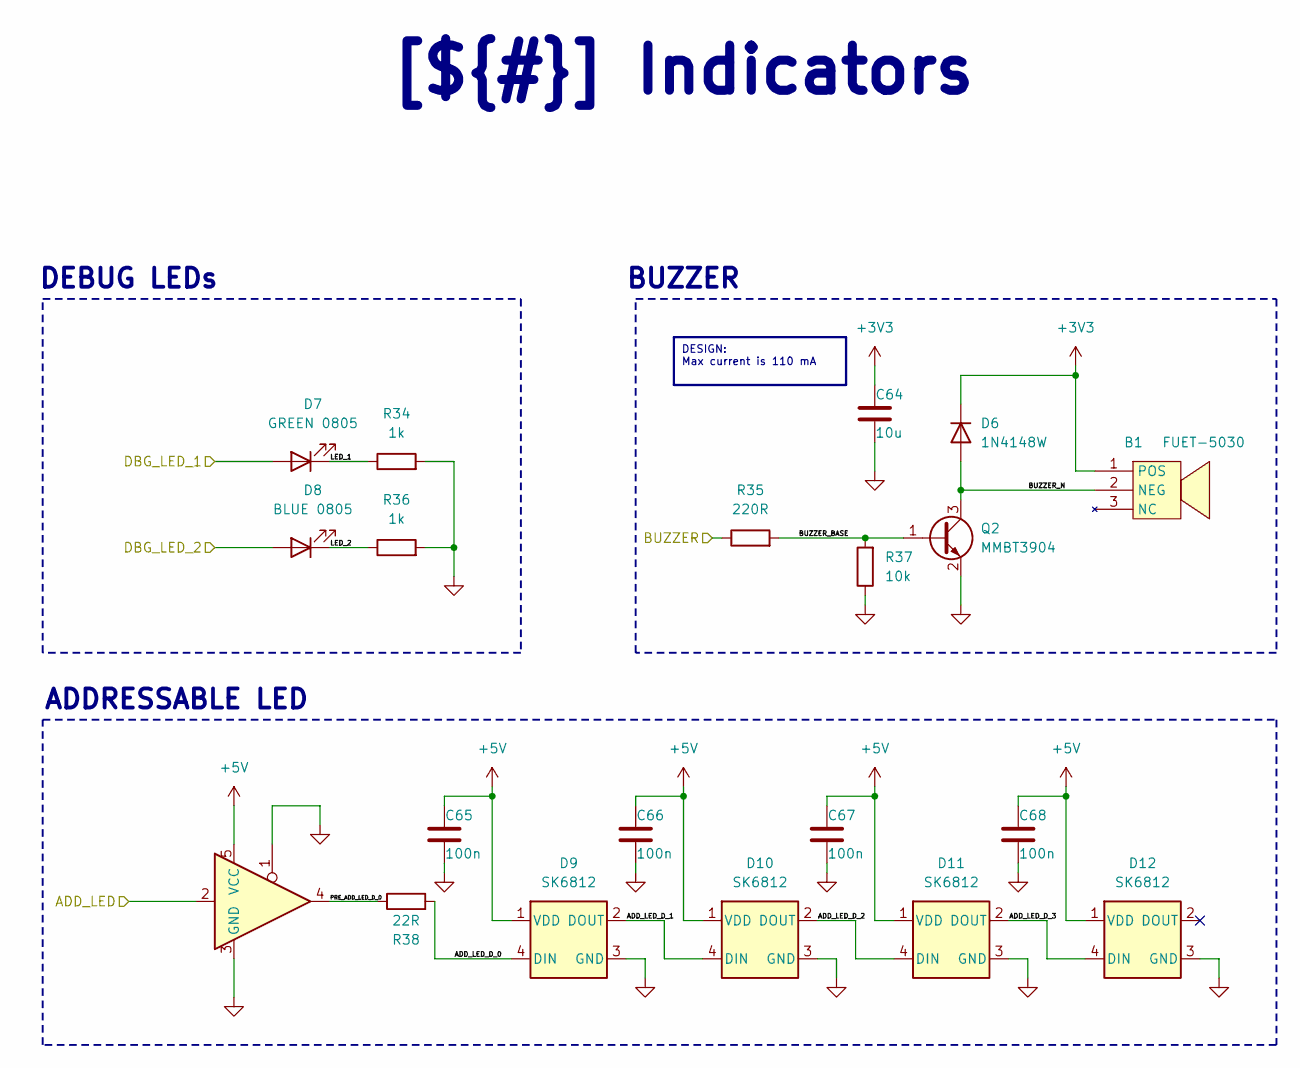
[picture p13: schematic indicators.kicad_sch]

Parts:
B1: FUET-5030; BUZ-SMD_FST-5030; LCSC C391031
C64: 10u; C_0805_2012Metric; LCSC C440198
C65, C66, C67, C68: 100n; C_0402_1005Metric; LCSC C307331
D6: 1N4148W; D_SOD-123; LCSC C2099
D7: GREEN 0805; LED_0805_2012Metric; LCSC C2297
D8: BLUE 0805; LED_0805_2012Metric; LCSC C84256
D9, D10, D11, D12: SK6812; LED-SMD_4P-L2.0-W2.0-BR; LCSC C2909058
Q2: MMBT3904; SOT-23; LCSC C7420353
R34, R36: 1k; R_0402_1005Metric; LCSC C106235
R35: 220R; R_0402_1005Metric; LCSC C25091
R37: 10k; R_0402_1005Metric; LCSC C25744
R38: 22R; R_0402_1005Metric; LCSC C2929994
U17: 74AHCT1G125; SOT-23-5; LCSC C20617903

Connections:
+3V3: B1.1 (POS), C64.1, D6.1 (K); also elsewhere on the board
+5V: C65.1, C66.1, C67.1, C68.1, D9.1 (VDD), D10.1 (VDD), D11.1 (VDD), D12.1 (VDD), U17.5 (VCC); also elsewhere on the board
/Architecture/Indicators/ADD_LED_D_0: D9.4 (DIN), R38.2
/Architecture/Indicators/ADD_LED_D_1: D9.2 (DOUT), D10.4 (DIN)
/Architecture/Indicators/ADD_LED_D_2: D10.2 (DOUT), D11.4 (DIN)
/Architecture/Indicators/ADD_LED_D_3: D11.2 (DOUT), D12.4 (DIN)
/Architecture/Indicators/BUZZER_BASE: Q2.1 (B), R35.2, R37.2
/Architecture/Indicators/BUZZER_N: B1.2 (NEG), D6.2 (A), Q2.3 (C)
/Architecture/Indicators/LED_1: D7.1 (K), R34.1
/Architecture/Indicators/LED_2: D8.1 (K), R36.1
/Architecture/Indicators/PRE_ADD_LED_D_0: R38.1, U17.4
/Architecture/MCU IO/ADD_LED: U17.2; also elsewhere on the board
/Architecture/MCU IO/BUZZER: R35.1; also elsewhere on the board
/Architecture/MCU IO/DBG_LED_1: D7.2 (A); also elsewhere on the board
/Architecture/MCU IO/DBG_LED_2: D8.2 (A); also elsewhere on the board
GND: C64.2, C65.2, C66.2, C67.2, C68.2, D9.3 (GND), D10.3 (GND), D11.3 (GND), D12.3 (GND), Q2.2 (E), R34.2, R36.2, R37.1, U17.1, U17.3 (GND); also elsewhere on the board

Notes on the sheet:
ADDRESSABLE LED
DEBUG LEDs
BUZZER
[${#}] ${TITLE}
DESIGN: Max current is 110 mA

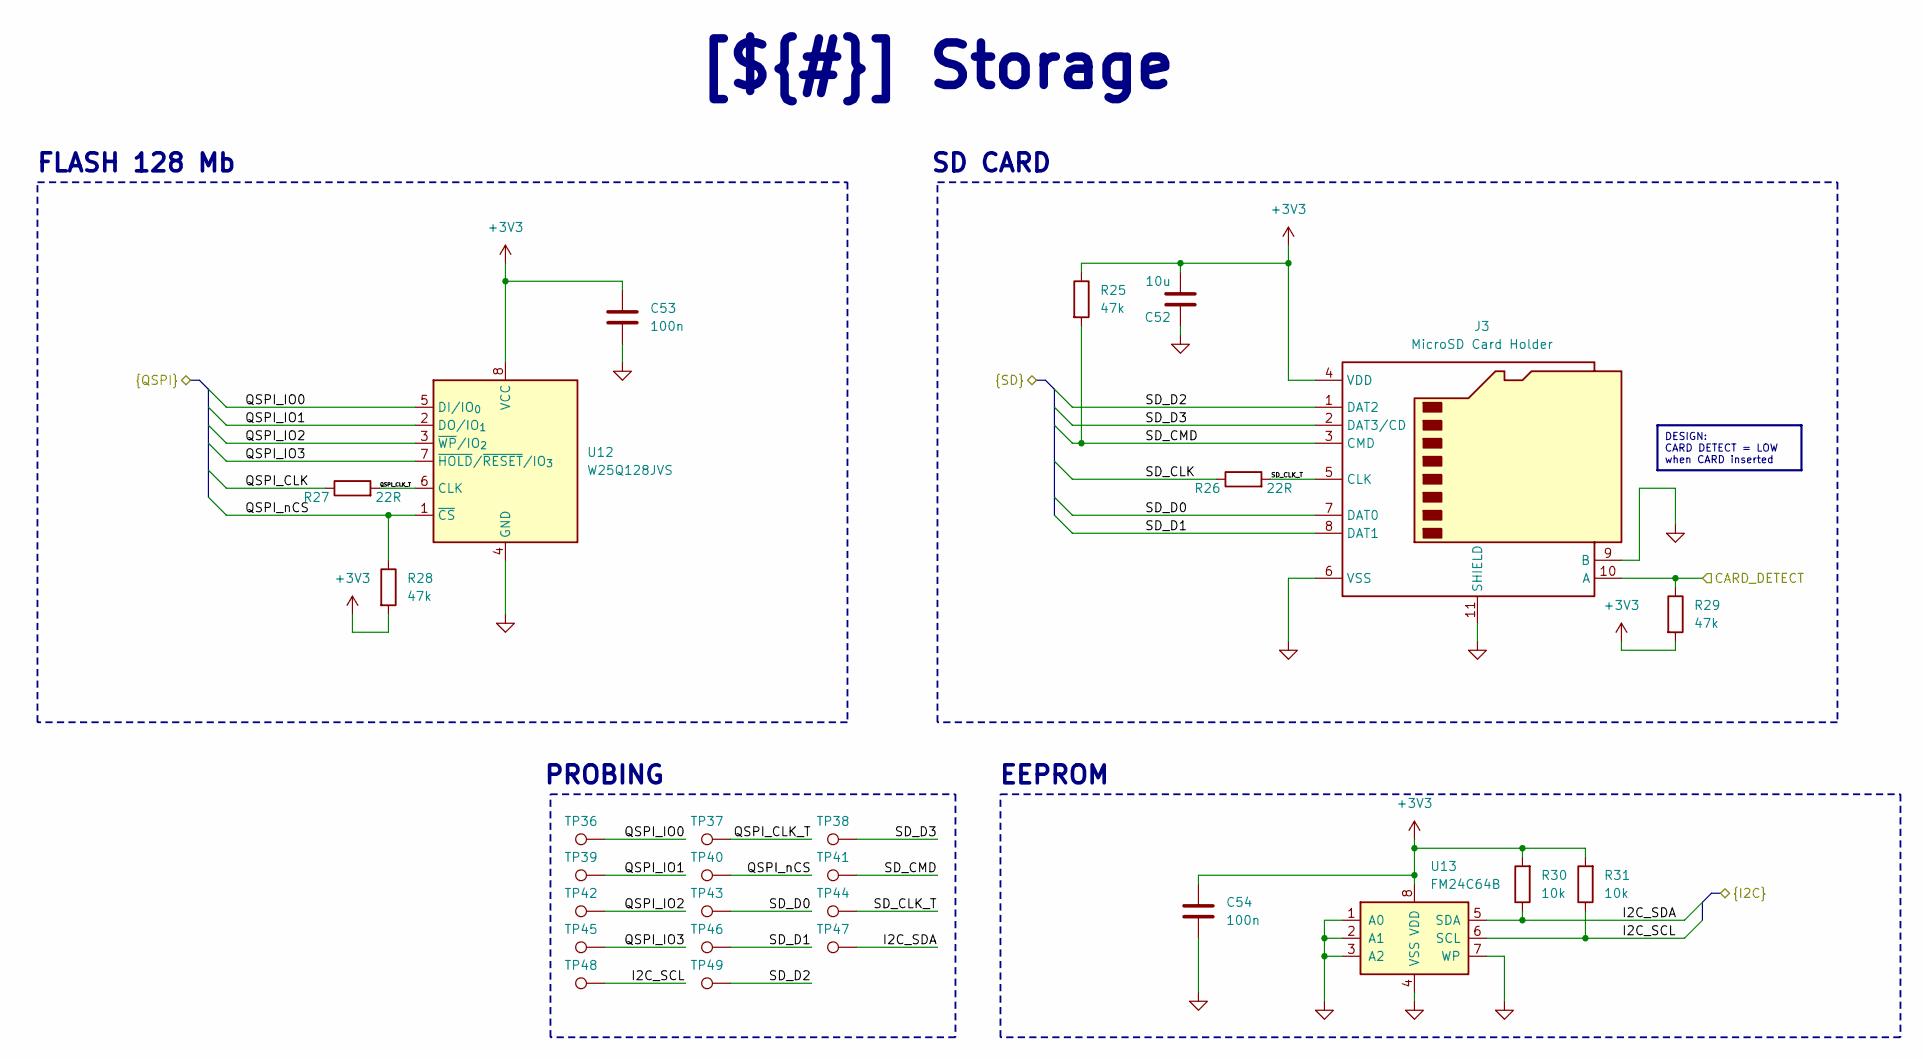
[picture p14: schematic storage.kicad_sch]

Parts:
C52: 10u; C_0805_2012Metric; LCSC C440198
C53, C54: 100n; C_0402_1005Metric; LCSC C307331
J3: MicroSD Card Holder; microSD_HC_Hirose_DM3D-SF; LCSC C719027
R25, R28, R29: 47k; R_0402_1005Metric; LCSC C25792
R26, R27: 22R; R_0402_1005Metric; LCSC C2929994
R30, R31: 10k; R_0402_1005Metric; LCSC C25744
TP36, TP37, TP38, TP39, TP40, TP41, TP42, TP43, TP44, TP45, TP46, TP47, TP48, TP49: TestPoint; TestPoint_Pad_1.0x1.0mm
U12: W25Q128JVS; SOIC-8_5.3x5.3mm_P1.27mm; LCSC C97521
U13: FM24C64B; SOIC-8_3.9x4.9mm_P1.27mm; LCSC C79988

Connections:
+3V3: C52.1, C53.1, C54.1, J3.4 (VDD), R25.1, R28.2, R29.2, R30.2, R31.2, U12.8 (VCC), U13.8 (VDD); also elsewhere on the board
/Architecture/MCU IO/CARD_DETECT: J3.10 (A), R29.1; also elsewhere on the board
/Architecture/MCU IO/I2C_SCL: R31.1, TP48.1, U13.6 (SCL); also elsewhere on the board
/Architecture/MCU IO/I2C_SDA: R30.1, TP47.1, U13.5 (SDA); also elsewhere on the board
/Architecture/MCU IO/QSPI_CLK: R27.1; also elsewhere on the board
/Architecture/MCU IO/QSPI_IO0: TP36.1, U12.5 (DI/IO_{0}); also elsewhere on the board
/Architecture/MCU IO/QSPI_IO1: TP39.1, U12.2 (DO/IO_{1}); also elsewhere on the board
/Architecture/MCU IO/QSPI_IO2: TP42.1, U12.3 (~WP/IO_{2}); also elsewhere on the board
/Architecture/MCU IO/QSPI_IO3: TP45.1, U12.7 (~HOLD/~RESET/IO_{3}); also elsewhere on the board
/Architecture/MCU IO/QSPI_nCS: R28.1, TP40.1, U12.1 (~CS); also elsewhere on the board
/Architecture/MCU IO/SD_CLK: R26.1; also elsewhere on the board
/Architecture/MCU IO/SD_CMD: J3.3 (CMD), R25.2, TP41.1; also elsewhere on the board
/Architecture/MCU IO/SD_D0: J3.7 (DAT0), TP43.1; also elsewhere on the board
/Architecture/MCU IO/SD_D1: J3.8 (DAT1), TP46.1; also elsewhere on the board
/Architecture/MCU IO/SD_D2: J3.1 (DAT2), TP49.1; also elsewhere on the board
/Architecture/MCU IO/SD_D3: J3.2 (DAT3/CD), TP38.1; also elsewhere on the board
/Architecture/Storage/QSPI_CLK_T: R27.2, TP37.1, U12.6 (CLK)
/Architecture/Storage/SD_CLK_T: J3.5 (CLK), R26.2, TP44.1
GND: C52.2, C53.2, C54.2, J3.6 (VSS), J3.9 (B), J3.11 (SHIELD), U12.4 (GND), U13.1 (A0), U13.2 (A1), U13.3 (A2), U13.4 (VSS), U13.7 (WP); also elsewhere on the board

Notes on the sheet:
FLASH 128 Mb
EEPROM
PROBING
SD CARD
DESIGN: CARD DETECT = LOW when CARD inserted
[${#}] ${TITLE}

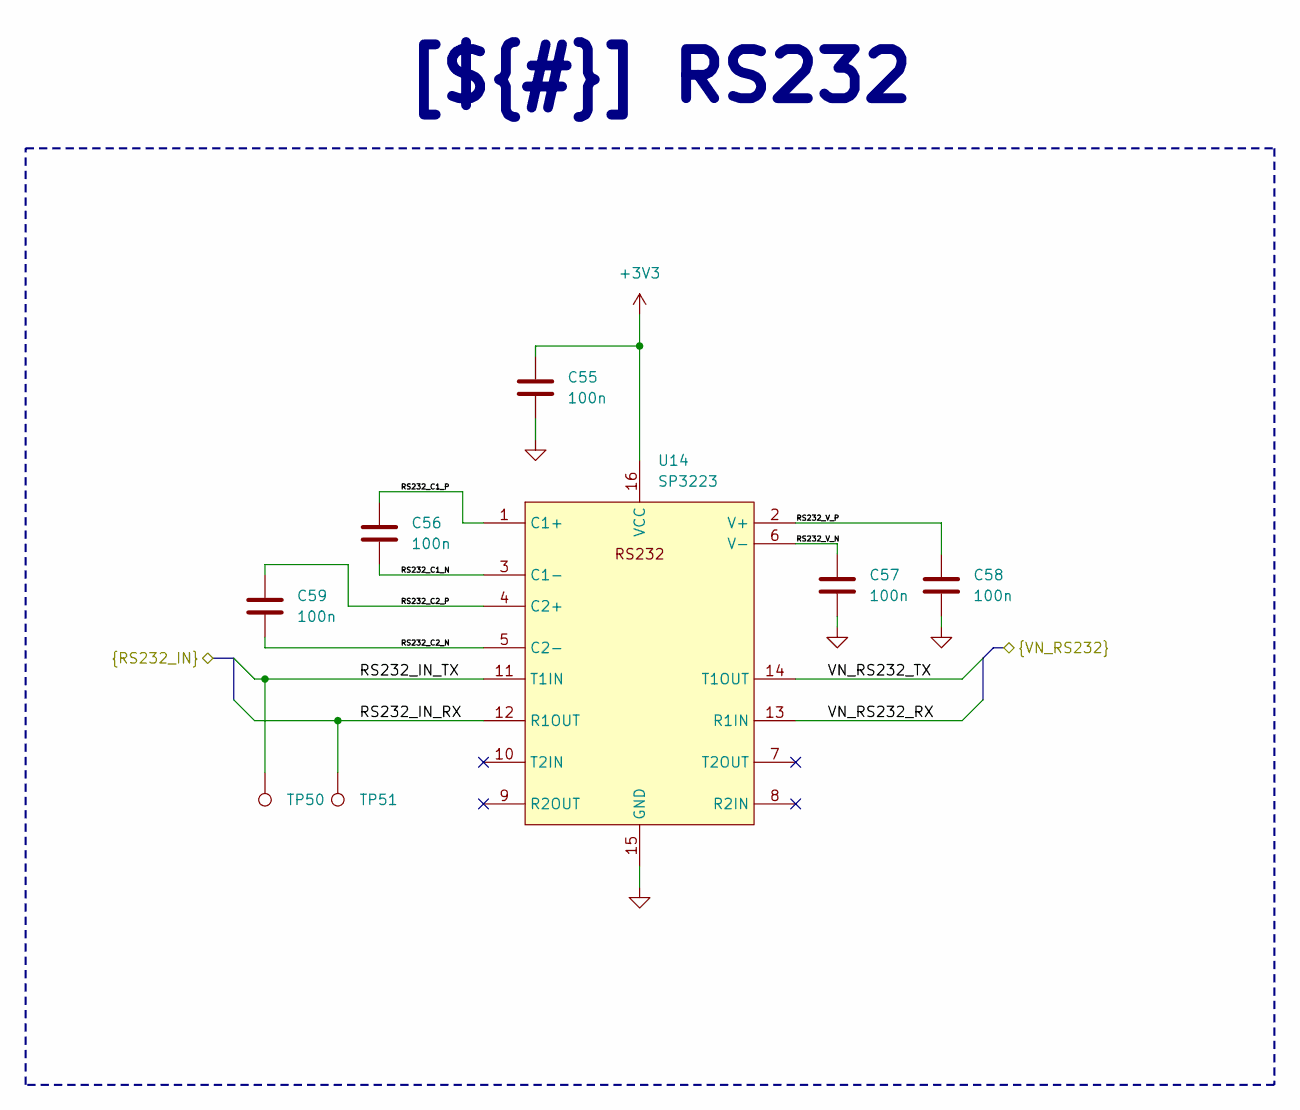
[picture p15: schematic rs232.kicad_sch]

Parts:
C55, C56, C57, C58, C59: 100n; C_0402_1005Metric; LCSC C307331
TP50, TP51: TestPoint; TestPoint_Pad_1.0x1.0mm
U14: SP3223; TSSOP-16_L5.0-W4.4-P0.65-LS6.4-BL; LCSC C2671803

Connections:
+3V3: C55.1, U14.16 (VCC); also elsewhere on the board
/Architecture/Interfaces - Sensors/VN_RS232_RX: U14.13 (R1IN); also elsewhere on the board
/Architecture/Interfaces - Sensors/VN_RS232_TX: U14.14 (T1OUT); also elsewhere on the board
/Architecture/MCU IO/RS232_IN_RX: TP51.1, U14.12 (R1OUT); also elsewhere on the board
/Architecture/MCU IO/RS232_IN_TX: TP50.1, U14.11 (T1IN); also elsewhere on the board
/Architecture/RS232/RS232_C1_N: C56.2, U14.3 (C1-)
/Architecture/RS232/RS232_C1_P: C56.1, U14.1 (C1+)
/Architecture/RS232/RS232_C2_N: C59.2, U14.5 (C2-)
/Architecture/RS232/RS232_C2_P: C59.1, U14.4 (C2+)
/Architecture/RS232/RS232_V_N: C57.1, U14.6 (V-)
/Architecture/RS232/RS232_V_P: C58.1, U14.2 (V+)
GND: C55.2, C57.2, C58.2, U14.15 (GND); also elsewhere on the board

Notes on the sheet:
[${#}] ${TITLE}
