SverreOK/hoppen_fc/hoppen_fc/hoppen_fc.kicad_pcb

## KiCad design hoppen_fc/hoppen_fc.kicad_pcb (continued)

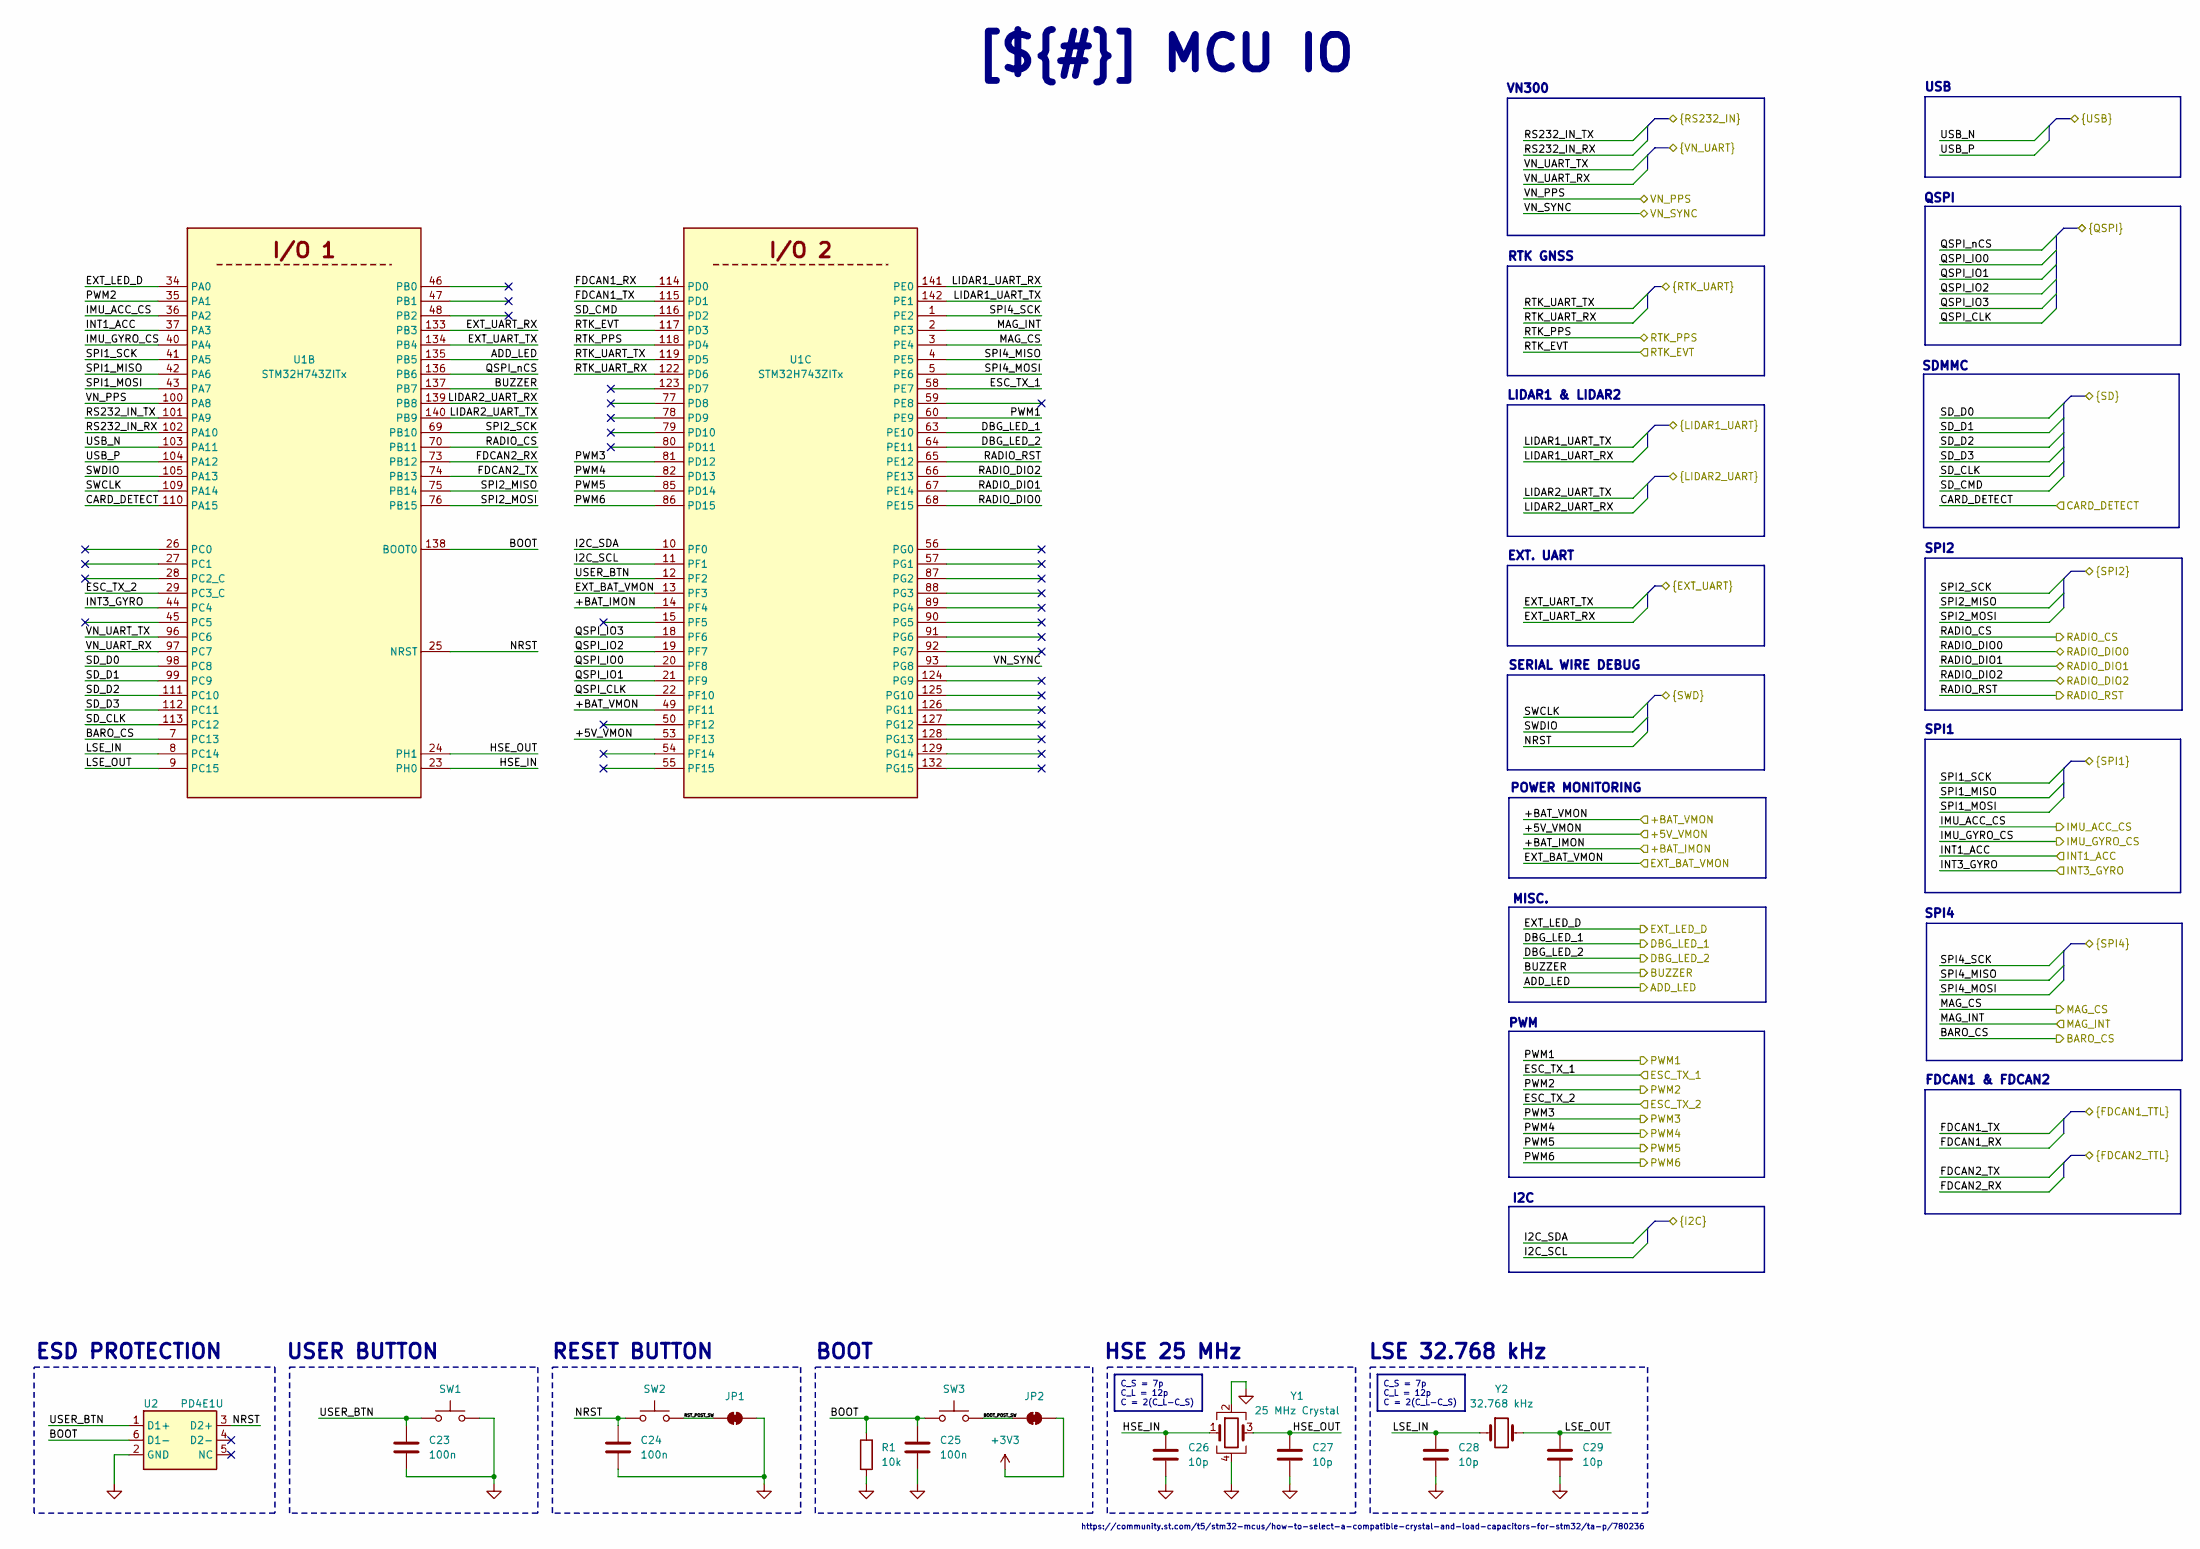
[picture p16: schematic mcu_io.kicad_sch, MCU IO]

Parts:
C23, C24, C25: 100n; C_0402_1005Metric; LCSC C307331
C26, C27, C28, C29: 10p; C_0402_1005Metric; LCSC C32949
JP1, JP2: J; SolderJumper-2_P1.3mm_Bridged_RoundedPad1.0x1.5mm
R1: 10k; R_0402_1005Metric; LCSC C25744
SW1, SW2, SW3: SW_Push; SW-SMD_L3.9-W3.0-P4.45; LCSC C720477
U1: STM32H743ZITx; LQFP-144_20x20mm_P0.5mm; LCSC C114408
U2: PD4E1U; SOT-363_SC-70-6; LCSC C194628
Y1: 25 MHz Crystal; Crystal_SMD_3225-4Pin_3.2x2.5mm; LCSC C9006
Y2: 32.768 kHz; Crystal_SMD_3215-2Pin; LCSC C32346

Connections:
+3V3: JP2.2 (B); also elsewhere on the board
/Architecture/FDCAN/FDCAN1_RX: U1.114 (PD0); also elsewhere on the board
/Architecture/FDCAN/FDCAN1_TX: U1.115 (PD1); also elsewhere on the board
/Architecture/FDCAN/FDCAN2_RX: U1.73 (PB12); also elsewhere on the board
/Architecture/FDCAN/FDCAN2_TX: U1.74 (PB13); also elsewhere on the board
/Architecture/Interfaces - Actuators/ESC_TX_1: U1.58 (PE7); also elsewhere on the board
/Architecture/Interfaces - Actuators/ESC_TX_2: U1.29 (PC3_C); also elsewhere on the board
/Architecture/Interfaces - Actuators/PWM1: U1.60 (PE9); also elsewhere on the board
/Architecture/Interfaces - Actuators/PWM2: U1.35 (PA1); also elsewhere on the board
/Architecture/Interfaces - Actuators/PWM3: U1.81 (PD12); also elsewhere on the board
/Architecture/Interfaces - Actuators/PWM4: U1.82 (PD13); also elsewhere on the board
/Architecture/Interfaces - Actuators/PWM5: U1.85 (PD14); also elsewhere on the board
/Architecture/Interfaces - Actuators/PWM6: U1.86 (PD15); also elsewhere on the board
/Architecture/Interfaces - Comms/EXT_UART_RX: U1.133 (PB3); also elsewhere on the board
/Architecture/Interfaces - Comms/EXT_UART_TX: U1.134 (PB4); also elsewhere on the board
/Architecture/Interfaces - Comms/NRST: C24.1, SW2.1, U1.25 (NRST), U2.3 (D2+); also elsewhere on the board
/Architecture/Interfaces - Comms/SWCLK: U1.109 (PA14); also elsewhere on the board
/Architecture/Interfaces - Comms/SWDIO: U1.105 (PA13); also elsewhere on the board
/Architecture/Interfaces - Sensors/LIDAR1_UART_RX: U1.141 (PE0); also elsewhere on the board
/Architecture/Interfaces - Sensors/LIDAR1_UART_TX: U1.142 (PE1); also elsewhere on the board
/Architecture/Interfaces - Sensors/LIDAR2_UART_RX: U1.139 (PB8); also elsewhere on the board
/Architecture/Interfaces - Sensors/LIDAR2_UART_TX: U1.140 (PB9); also elsewhere on the board
/Architecture/Interfaces - Sensors/RTK_UART_RX: U1.122 (PD6); also elsewhere on the board
/Architecture/Interfaces - Sensors/RTK_UART_TX: U1.119 (PD5); also elsewhere on the board
/Architecture/Interfaces - Sensors/VN_UART_RX: U1.97 (PC7); also elsewhere on the board
/Architecture/Interfaces - Sensors/VN_UART_TX: U1.96 (PC6); also elsewhere on the board
/Architecture/MCU IO/+5V_VMON: U1.53 (PF13); also elsewhere on the board
/Architecture/MCU IO/+BAT_IMON: U1.14 (PF4); also elsewhere on the board
/Architecture/MCU IO/+BAT_VMON: U1.49 (PF11); also elsewhere on the board
/Architecture/MCU IO/ADD_LED: U1.135 (PB5); also elsewhere on the board
/Architecture/MCU IO/BARO_CS: U1.7 (PC13); also elsewhere on the board
/Architecture/MCU IO/BOOT: C25.1, R1.2, SW3.1, U1.138 (BOOT0), U2.6 (D1-)
/Architecture/MCU IO/BOOT_POST_SW: JP2.1 (A), SW3.2
/Architecture/MCU IO/BUZZER: U1.137 (PB7); also elsewhere on the board
/Architecture/MCU IO/CARD_DETECT: U1.110 (PA15); also elsewhere on the board
/Architecture/MCU IO/DBG_LED_1: U1.63 (PE10); also elsewhere on the board
/Architecture/MCU IO/DBG_LED_2: U1.64 (PE11); also elsewhere on the board
/Architecture/MCU IO/EXT_BAT_VMON: U1.13 (PF3); also elsewhere on the board
/Architecture/MCU IO/EXT_LED_D: U1.34 (PA0); also elsewhere on the board
/Architecture/MCU IO/HSE_IN: C26.2, U1.23 (PH0), Y1.1
/Architecture/MCU IO/HSE_OUT: C27.2, U1.24 (PH1), Y1.3
/Architecture/MCU IO/I2C_SCL: U1.11 (PF1); also elsewhere on the board
/Architecture/MCU IO/I2C_SDA: U1.10 (PF0); also elsewhere on the board
/Architecture/MCU IO/IMU_ACC_CS: U1.36 (PA2); also elsewhere on the board
/Architecture/MCU IO/IMU_GYRO_CS: U1.40 (PA4); also elsewhere on the board
/Architecture/MCU IO/INT1_ACC: U1.37 (PA3); also elsewhere on the board
/Architecture/MCU IO/INT3_GYRO: U1.44 (PC4); also elsewhere on the board
/Architecture/MCU IO/LSE_IN: C28.2, U1.8 (PC14), Y2.1
/Architecture/MCU IO/LSE_OUT: C29.2, U1.9 (PC15), Y2.2
/Architecture/MCU IO/MAG_CS: U1.3 (PE4); also elsewhere on the board
/Architecture/MCU IO/MAG_INT: U1.2 (PE3); also elsewhere on the board
/Architecture/MCU IO/QSPI_CLK: U1.22 (PF10); also elsewhere on the board
/Architecture/MCU IO/QSPI_IO0: U1.20 (PF8); also elsewhere on the board
/Architecture/MCU IO/QSPI_IO1: U1.21 (PF9); also elsewhere on the board
/Architecture/MCU IO/QSPI_IO2: U1.19 (PF7); also elsewhere on the board
/Architecture/MCU IO/QSPI_IO3: U1.18 (PF6); also elsewhere on the board
/Architecture/MCU IO/QSPI_nCS: U1.136 (PB6); also elsewhere on the board
/Architecture/MCU IO/RADIO_CS: U1.70 (PB11); also elsewhere on the board
/Architecture/MCU IO/RADIO_DIO0: U1.68 (PE15); also elsewhere on the board
/Architecture/MCU IO/RADIO_DIO1: U1.67 (PE14); also elsewhere on the board
/Architecture/MCU IO/RADIO_DIO2: U1.66 (PE13); also elsewhere on the board
/Architecture/MCU IO/RADIO_RST: U1.65 (PE12); also elsewhere on the board
/Architecture/MCU IO/RS232_IN_RX: U1.102 (PA10); also elsewhere on the board
/Architecture/MCU IO/RS232_IN_TX: U1.101 (PA9); also elsewhere on the board
/Architecture/MCU IO/RST_POST_SW: JP1.1 (A), SW2.2
/Architecture/MCU IO/RTK_EVT: U1.117 (PD3); also elsewhere on the board
/Architecture/MCU IO/RTK_PPS: U1.118 (PD4); also elsewhere on the board
/Architecture/MCU IO/SD_CLK: U1.113 (PC12); also elsewhere on the board
/Architecture/MCU IO/SD_CMD: U1.116 (PD2); also elsewhere on the board
/Architecture/MCU IO/SD_D0: U1.98 (PC8); also elsewhere on the board
/Architecture/MCU IO/SD_D1: U1.99 (PC9); also elsewhere on the board
/Architecture/MCU IO/SD_D2: U1.111 (PC10); also elsewhere on the board
/Architecture/MCU IO/SD_D3: U1.112 (PC11); also elsewhere on the board
/Architecture/MCU IO/SPI1_MISO: U1.42 (PA6); also elsewhere on the board
/Architecture/MCU IO/SPI1_MOSI: U1.43 (PA7); also elsewhere on the board
/Architecture/MCU IO/SPI1_SCK: U1.41 (PA5); also elsewhere on the board
/Architecture/MCU IO/SPI2_MISO: U1.75 (PB14); also elsewhere on the board
/Architecture/MCU IO/SPI2_MOSI: U1.76 (PB15); also elsewhere on the board
/Architecture/MCU IO/SPI2_SCK: U1.69 (PB10); also elsewhere on the board
/Architecture/MCU IO/SPI4_MISO: U1.4 (PE5); also elsewhere on the board
/Architecture/MCU IO/SPI4_MOSI: U1.5 (PE6); also elsewhere on the board
/Architecture/MCU IO/SPI4_SCK: U1.1 (PE2); also elsewhere on the board
/Architecture/MCU IO/USB_N: U1.103 (PA11); also elsewhere on the board
/Architecture/MCU IO/USB_P: U1.104 (PA12); also elsewhere on the board
/Architecture/MCU IO/USER_BTN: C23.1, SW1.1, U1.12 (PF2), U2.1 (D1+)
/Architecture/MCU IO/VN_PPS: U1.100 (PA8); also elsewhere on the board
/Architecture/MCU IO/VN_SYNC: U1.93 (PG8); also elsewhere on the board
GND: C23.2, C24.2, C25.2, C26.1, C27.1, C28.1, C29.1, JP1.2 (B), R1.1, SW1.2, U2.2 (GND), Y1.2, Y1.4; also elsewhere on the board

Notes on the sheet:
SPI4
https://community.st.com/t5/stm32-mcus/how-to-select-a-compatible-crystal-and-load-capacitors-for-stm32/ta-p/780236
USB
QSPI
HSE 25 MHz
POWER MONITORING
SPI1
EXT. UART
SDMMC
BOOT
FDCAN1 & FDCAN2
SERIAL WIRE DEBUG
LIDAR1 & LIDAR2
I2C
PWM
VN300
RESET BUTTON
LSE 32.768 kHz
RTK GNSS
SPI2
ESD PROTECTION
USER BUTTON
MISC.
[${#}] ${TITLE}
C_S = 7p C_L = 12p C = 2(C_L-C_S)

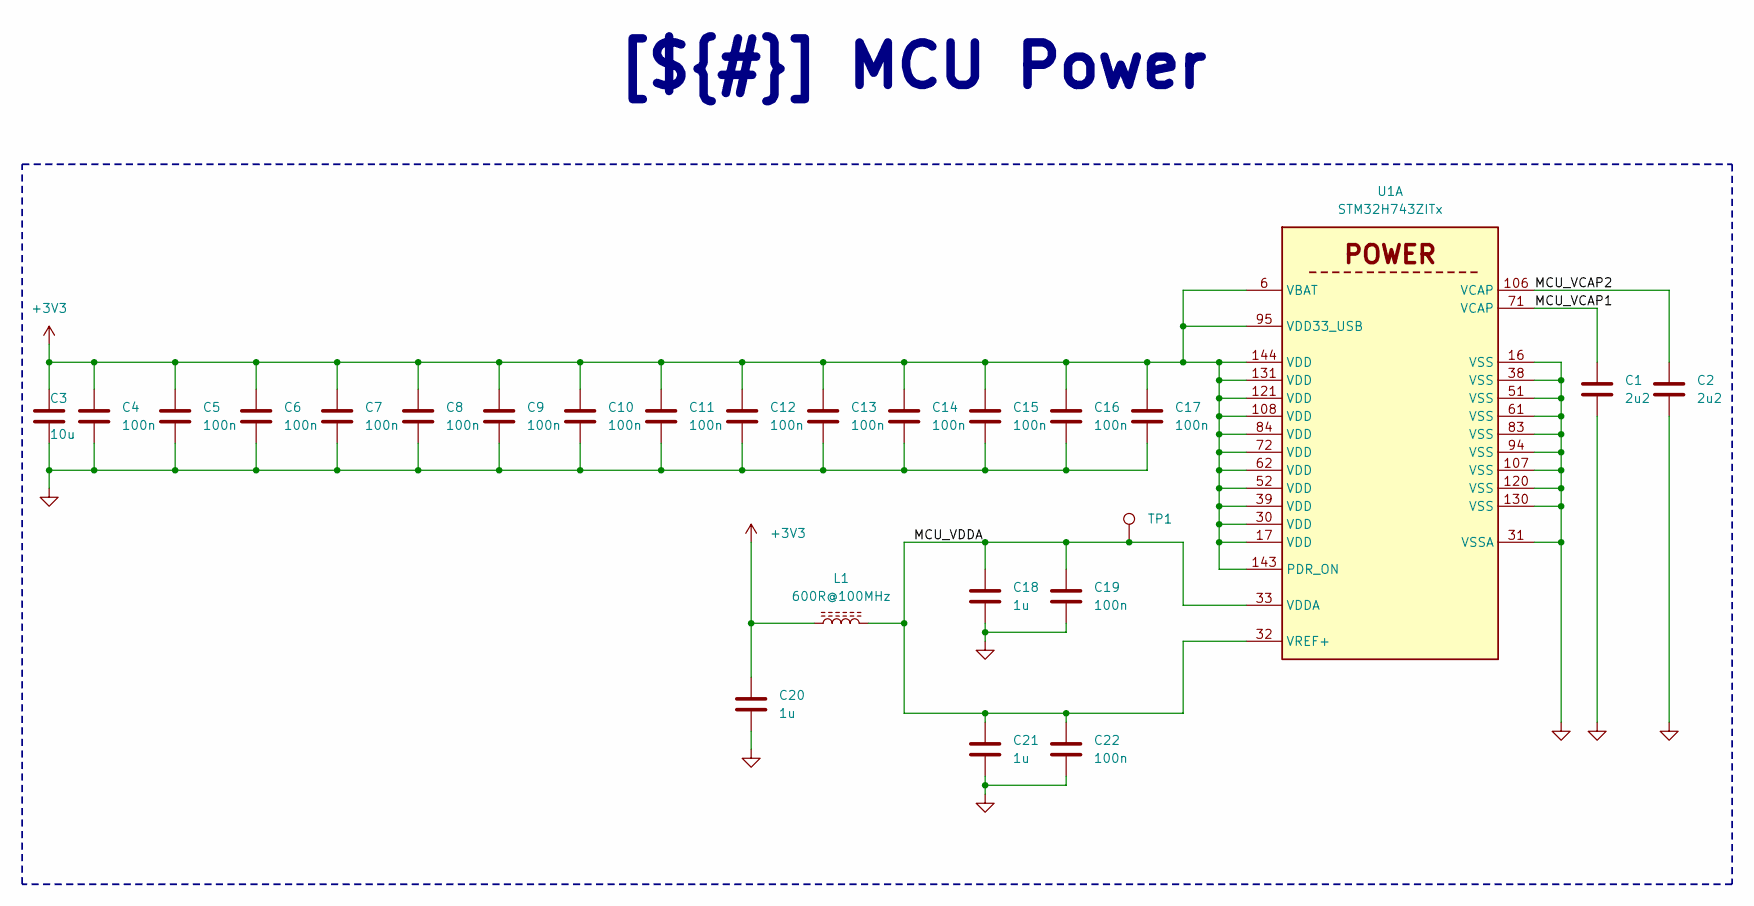
[picture p17: schematic mcu_power.kicad_sch, MCU Power]

Parts:
C1, C2: 2u2; C_0603_1608Metric; LCSC C23630
C3: 10u; C_0805_2012Metric; LCSC C440198
C4, C5, C6, C7, C8, C9, C10, C11, C12, C13, C14, C15, C16, C17, C19, C22: 100n; C_0402_1005Metric; LCSC C307331
C18, C20, C21: 1u; C_0402_1005Metric; LCSC C52923
L1: 600R@100MHz; L_0603_1608Metric; LCSC C1002
TP1: TestPoint; TestPoint_Pad_1.0x1.0mm
U1: STM32H743ZITx; LQFP-144_20x20mm_P0.5mm; LCSC C114408

Connections:
+3V3: C3.1, C4.1, C5.1, C6.1, C7.1, C8.1, C9.1, C10.1, C11.1, C12.1, C13.1, C14.1, C15.1, C16.1, C17.1, C20.1, L1.1, U1.6 (VBAT), U1.17 (VDD), U1.30 (VDD), U1.39 (VDD), U1.52 (VDD), U1.62 (VDD), U1.72 (VDD), U1.84 (VDD), U1.95 (VDD33_USB), U1.108 (VDD), U1.121 (VDD), U1.131 (VDD), U1.143 (PDR_ON), U1.144 (VDD); also elsewhere on the board
/Architecture/MCU Power/MCU_VCAP1: C1.1, U1.71 (VCAP)
/Architecture/MCU Power/MCU_VCAP2: C2.1, U1.106 (VCAP)
/Architecture/MCU Power/MCU_VDDA: C18.1, C19.1, C21.1, C22.1, L1.2, TP1.1, U1.32 (VREF+), U1.33 (VDDA)
GND: C1.2, C2.2, C3.2, C4.2, C5.2, C6.2, C7.2, C8.2, C9.2, C10.2, C11.2, C12.2, C13.2, C14.2, C15.2, C16.2, C17.2, C18.2, C19.2, C20.2, C21.2, C22.2, U1.16 (VSS), U1.31 (VSSA), U1.38 (VSS), U1.51 (VSS), U1.61 (VSS), U1.83 (VSS), U1.94 (VSS), U1.107 (VSS), U1.120 (VSS), U1.130 (VSS); also elsewhere on the board

Notes on the sheet:
[${#}] ${TITLE}

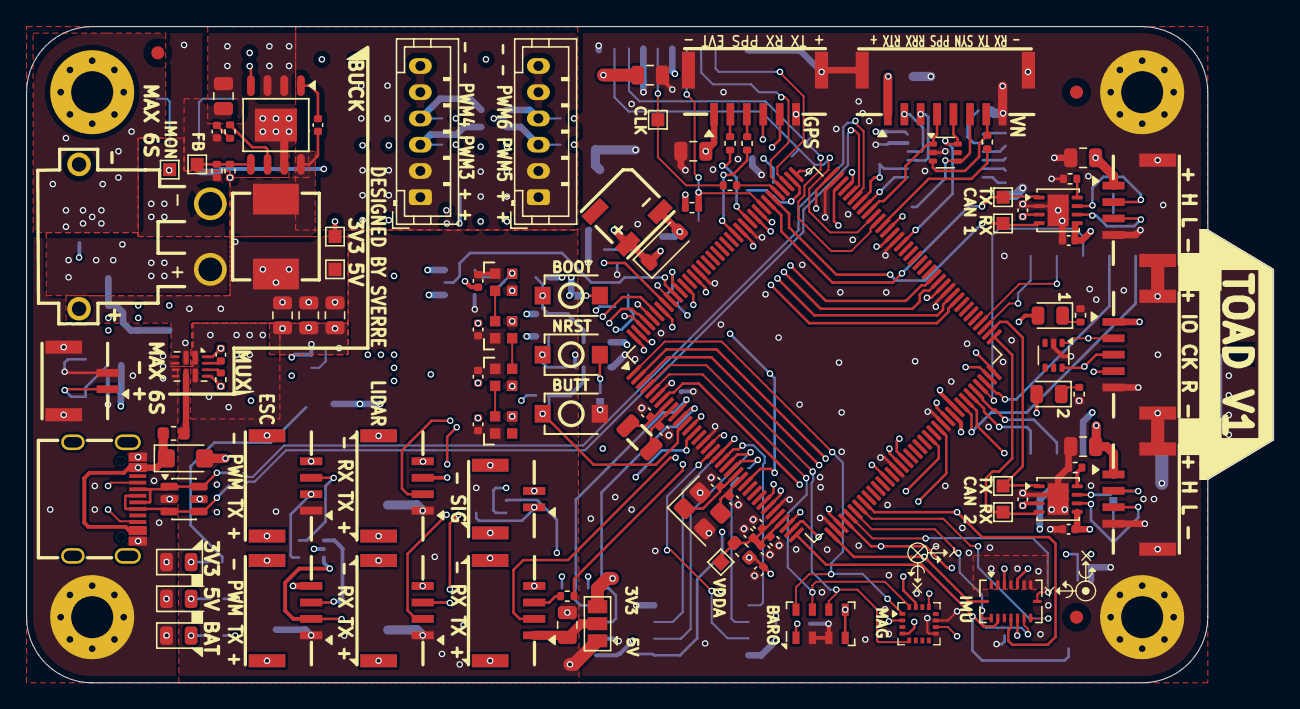
[picture p18: board hoppen_fc.kicad_pcb from above]

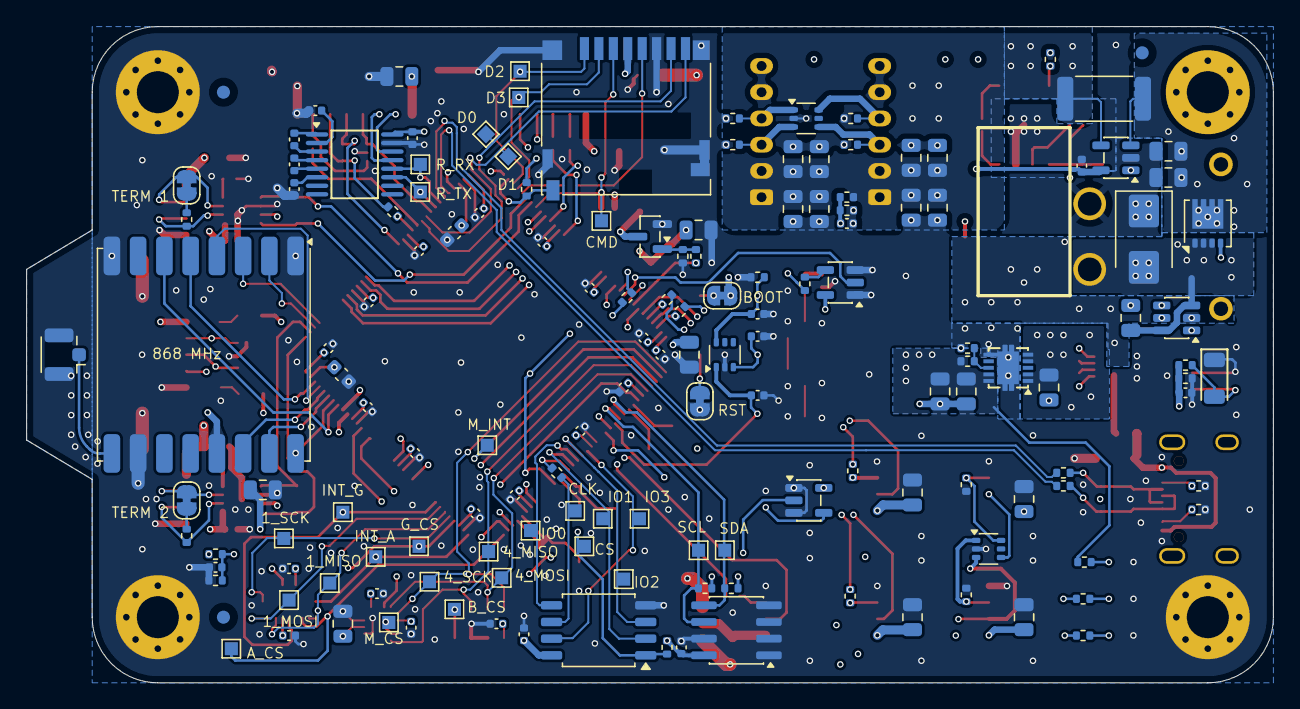
[picture p19: board hoppen_fc.kicad_pcb from below]

Board: 6 copper layers, 95.0 x 50.0 mm, 261 parts (151 on the bottom side), 158 nets.

Other parts of the board:
TP5: TestPoint; TestPoint_Pad_1.0x1.0mm

Their connections:
+5V_EXT: TP5.1; also elsewhere on the board
