SverreOK/hoppen_fc/hoppen_fc/CubeMX/hoppen_stm32h743zgt6.ioc

Mcu.UserName=STM32H743ZGTx
PA0.GPIO_Label=EXT_LED_TIM5_CH1
PA0.Signal=S_TIM5_CH1
PA1.GPIO_Label=PWM2_TIM2_CH2
PA1.Signal=S_TIM2_CH2
PA10.GPIO_Label=RS232_IN_USART1_RX
PA10.Signal=USART1_RX
PA11.Signal=USB_OTG_FS_DM
PA12.Signal=USB_OTG_FS_DP
PA2.GPIO_Label=IMU_ACC_CS
PA2.Signal=GPIO_Output
PA3.GPIO_Label=INT1_ACC
PA3.Signal=GPIO_Input
PA4.GPIO_Label=IMU_GYRO_CS
PA4.Signal=GPIO_Output
PA5.Signal=SPI1_SCK
PA6.Signal=SPI1_MISO
PA7.Signal=SPI1_MOSI
PA8.GPIO_Label=VN_PPS
PA8.Signal=GPIO_Input
PA9.GPIO_Label=RS232_IN_USART1_TX
PA9.Signal=USART1_TX
PB10.Signal=SPI2_SCK
PB11.GPIO_Label=RADIO_CS
PB11.Signal=GPIO_Output
PB12.Signal=FDCAN2_RX
PB13.Signal=FDCAN2_TX
PB14.Signal=SPI2_MISO
PB15.Signal=SPI2_MOSI
PB5.GPIO_Label=LED_TIM3_CH2
PB5.Signal=S_TIM3_CH2
PB6.Signal=QUADSPI_BK1_NCS
PB7.GPIO_Label=BUZZER_TIM17_CH1N
PB7.Signal=TIM17_CH1N
PB8.GPIO_Label=LIDAR2_UART4_RX
PB8.Signal=UART4_RX
PB9.GPIO_Label=LIDAR2_UART4_TX
PB9.Signal=UART4_TX
PC10.Signal=SDMMC1_D2
PC11.Signal=SDMMC1_D3
PC12.Signal=SDMMC1_CK
PC13.GPIO_Label=BARO_CS
PC13.Signal=GPIO_Output
PC3_C.GPIO_Label=ESC_TX_2
PC3_C.Signal=GPIO_Output
PC4.GPIO_Label=INT3_GYRO
PC4.Signal=GPIO_Input
PC6.GPIO_Label=VN_USART6_TX
PC6.Signal=USART6_TX
PC7.GPIO_Label=VN_USART6_RX
PC7.Signal=USART6_RX
PC8.Signal=SDMMC1_D0
PC9.Signal=SDMMC1_D1
PD0.Signal=FDCAN1_RX
PD1.Signal=FDCAN1_TX
PD12.GPIO_Label=PWM3
PD12.Signal=S_TIM4_CH1
PD13.GPIO_Label=PWM4
PD13.Signal=S_TIM4_CH2
PD14.GPIO_Label=PWM5
PD14.Signal=S_TIM4_CH3
PD15.GPIO_Label=PWM6
PD15.Signal=S_TIM4_CH4
PD2.Signal=SDMMC1_CMD
PD3.GPIO_Label=RTK_EVT
PD3.Signal=GPIO_Input
PD4.GPIO_Label=RTK_PPS
PD4.Signal=GPIO_Input
PD5.GPIO_Label=RTK_USART2_TX
PD5.Signal=USART2_TX
PD6.GPIO_Label=RTK_USART2_RX
PD6.Signal=USART2_RX
PE0.GPIO_Label=LIDAR1_UART_RX
PE0.Signal=UART8_RX
PE1.GPIO_Label=LIDAR1_UART8_TX
PE1.Signal=UART8_TX
PE10.GPIO_Label=LED_1
PE10.Signal=GPIO_Output
PE11.GPIO_Label=LED_2
PE11.Signal=GPIO_Output
PE12.GPIO_Label=RADIO_RST
PE12.Signal=GPIO_Output
PE13.GPIO_Label=RADIO_DIO2
PE13.Signal=GPIO_Output
PE14.GPIO_Label=RADIO_DIO1
PE14.Signal=GPIO_Output
PE15.GPIO_Label=RADIO_DIO0
PE15.Signal=GPIO_Output
PE2.Signal=SPI4_SCK
PE3.GPIO_Label=MAG_INT
PE3.Signal=GPIO_Input
PE4.GPIO_Label=MAG_CS
PE4.Signal=GPIO_Output
PE5.Signal=SPI4_MISO
PE6.Signal=SPI4_MOSI
PE7.GPIO_Label=ESC_RX_1
PE7.Signal=GPIO_Input
PE9.GPIO_Label=PWM1_TIM1_CH1
PE9.Signal=S_TIM1_CH1
PF0.Signal=I2C2_SDA
PF1.Signal=I2C2_SCL
PF10.Signal=QUADSPI_CLK
PF11.GPIO_Label=BAT_VMON_ADC1_INP2
PF11.Signal=ADC1_INP2
PF13.GPIO_Label=VMON_ADC2_INP2
PF13.Signal=ADC2_INP2
PF2.GPIO_Label=USER_BTN
PF2.Signal=GPIO_Input
PF3.GPIO_Label=EXT_BAT_ADC3_INP5
PF3.Signal=ADC3_INP5
PF4.GPIO_Label=IMON_ADC3_INP9
PF4.Signal=ADC3_INP9
PF6.Signal=QUADSPI_BK1_IO3
PF7.Signal=QUADSPI_BK1_IO2
PF8.Signal=QUADSPI_BK1_IO0
PF9.Signal=QUADSPI_BK1_IO1
PG10.GPIO_Label=SPI6_CS_2
PG10.Signal=GPIO_Output
PG11.GPIO_Label=SPI6_CS_1
PG11.Signal=GPIO_Output
PG12.Signal=SPI6_MISO
PG13.Signal=SPI6_SCK
PG14.Signal=SPI6_MOSI
PG8.GPIO_Label=VN_SYNC
PG8.Signal=GPIO_Output
