SverreOK/hoppen_fc/(commit log)

2025-12-13 added mcu and some more project changes
    [architecture.kicad_sch, block_diagram.kicad_sch, hoppen_fc.kicad_sch, mcu_io.kicad_sch, mcu_power.kicad_sch]
2025-12-14 more passives work
    [architecture.kicad_sch, block_diagram.kicad_sch, mcu_io.kicad_sch, mcu_power.kicad_sch]
2025-12-15 sensors done, mcu worked on
    [architecture.kicad_sch, block_diagram.kicad_sch, hoppen_fc.kicad_sch, mcu_io.kicad_sch, mcu_power.kicad_sch, sensors.kicad_sch]
2025-12-15 rs232,can,ind,storage,usb v01
    [architecture.kicad_sch, canbus.kicad_sch, indicators.kicad_sch, interface.kicad_sch, mcu_io.kicad_sch, mcu_power.kicad_sch, misc.kicad_sch, power.kicad_sch]
2025-12-18 wen branch and pr
    [architecture.kicad_sch, canbus.kicad_sch, hoppen_fc.kicad_sch, indicators.kicad_sch, interface.kicad_sch, mcu_io.kicad_sch, mcu_power.kicad_sch, misc.kicad_sch]
2025-12-18 much work and .ioc file added
    [architecture.kicad_sch, canbus.kicad_sch, indicators.kicad_sch, interface.kicad_sch, mcu_io.kicad_sch, mcu_power.kicad_sch, power.kicad_sch, rs232.kicad_sch]
2025-12-22 start fix fp
    [canbus.kicad_sch, indicators.kicad_sch, interface.kicad_sch, mcu_io.kicad_sch, misc.kicad_sch, rs232.kicad_sch, storage.kicad_sch, usb.kicad_sch]
2025-12-23 reformat structure
    [architecture.kicad_sch, block_diagram.kicad_sch, canbus.kicad_sch, hoppen_fc.kicad_pcb, hoppen_fc.kicad_sch, indicators.kicad_sch, interface.kicad_sch, mcu_io.kicad_sch]
2025-12-23 remove radio.sch
    [radio.kicad_sch]
2025-12-29 power input/generation reworked
    [architecture.kicad_sch, interface.kicad_sch, mcu_io.kicad_sch, power.kicad_sch, power_generation.kicad_sch, power_input.kicad_sch]
2025-12-29 finished routing, starting doublechecking and componenting
    [interface.kicad_sch, mcu_power.kicad_sch, power_generation.kicad_sch, power_input.kicad_sch]
2025-12-31 finished adding lcsc numbers
    [architecture.kicad_sch, block_diagram.kicad_sch, canbus.kicad_sch, hoppen_fc.kicad_sch, indicators.kicad_sch, interface.kicad_sch, mcu_io.kicad_sch, mcu_power.kicad_sch]
2026-01-02 ready for routing?
    [architecture.kicad_sch, hoppen_fc.kicad_pcb, indicators.kicad_sch, interface.kicad_sch, mcu_io.kicad_sch, misc.kicad_sch, power_generation.kicad_sch, power_input.kicad_sch]
2026-01-05 routing and adding rf module
    [architecture.kicad_sch, canbus.kicad_sch, hoppen_fc.kicad_pcb, indicators.kicad_sch, interface.kicad_sch, power_generation.kicad_sch, power_input.kicad_sch, radio.kicad_sch]
2026-02-10 add connectors
2026-03-31 production v1
    [hoppen_fc.kicad_pcb, hoppen_fc_bom.csv, hoppen_fc_designators.csv, hoppen_fc_positions.csv, indicators.kicad_sch, interfaces_comms.kicad_sch, mcu_io.kicad_sch, power_generation.kicad_sch]
